ArnavMK/WaveForge/Galery/Boards/Shoyu/3D.png

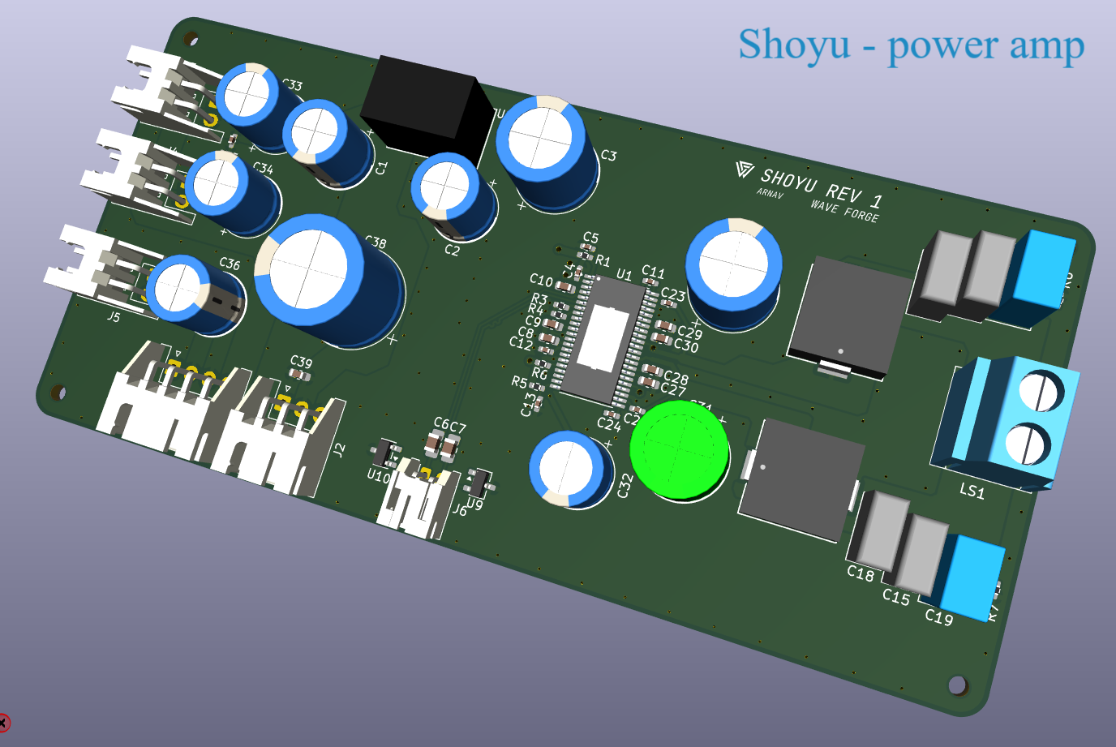
Galery/Boards/Shoyu/3D.png
