ArnavMK/WaveForge/Galery/Boards/Gen/3D.png

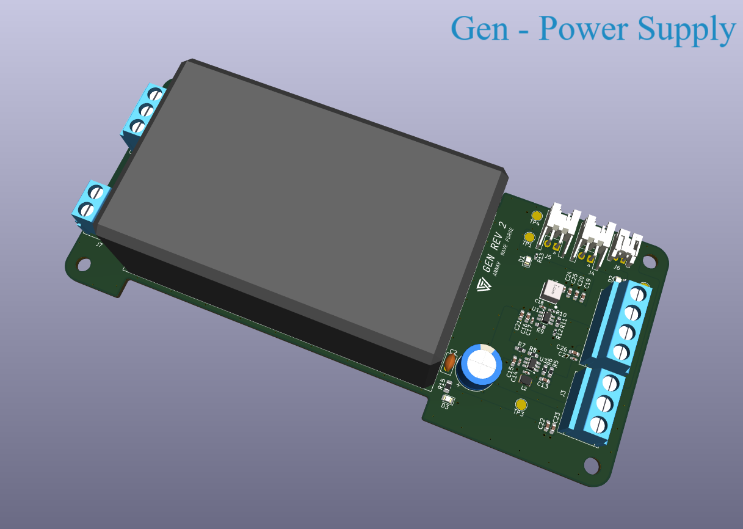
Galery/Boards/Gen/3D.png
