ArnavMK/WaveForge/Galery/Boards/Gen/back_layer.png

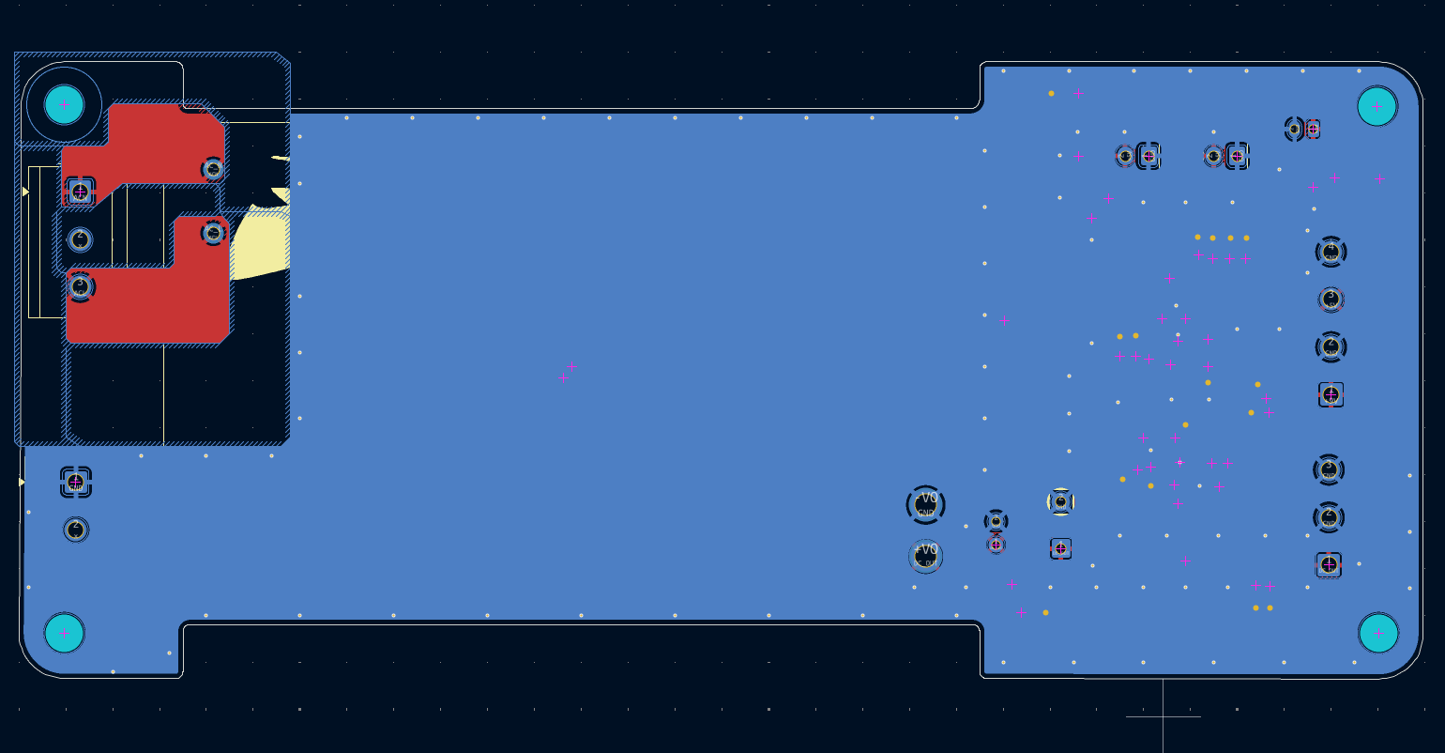
Galery/Boards/Gen/back_layer.png
