ArnavMK/WaveForge/Galery/Boards/Gen/front_layer.png

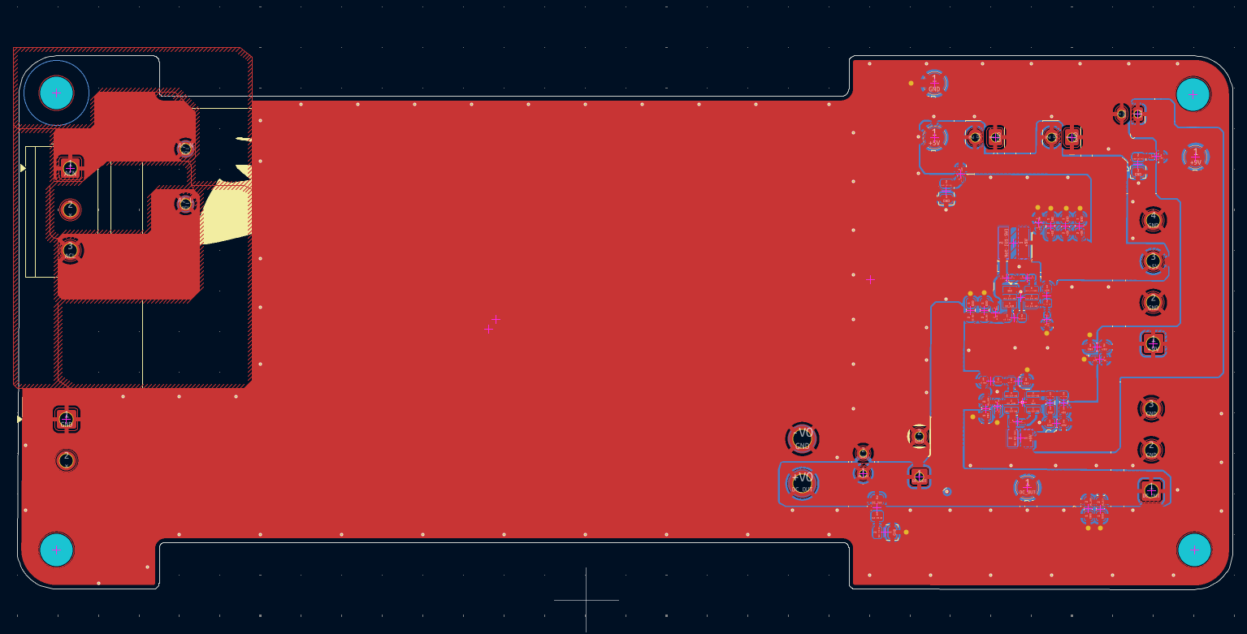
Galery/Boards/Gen/front_layer.png
