ArnavMK/WaveForge/Galery/Boards/Gen/full_board.png

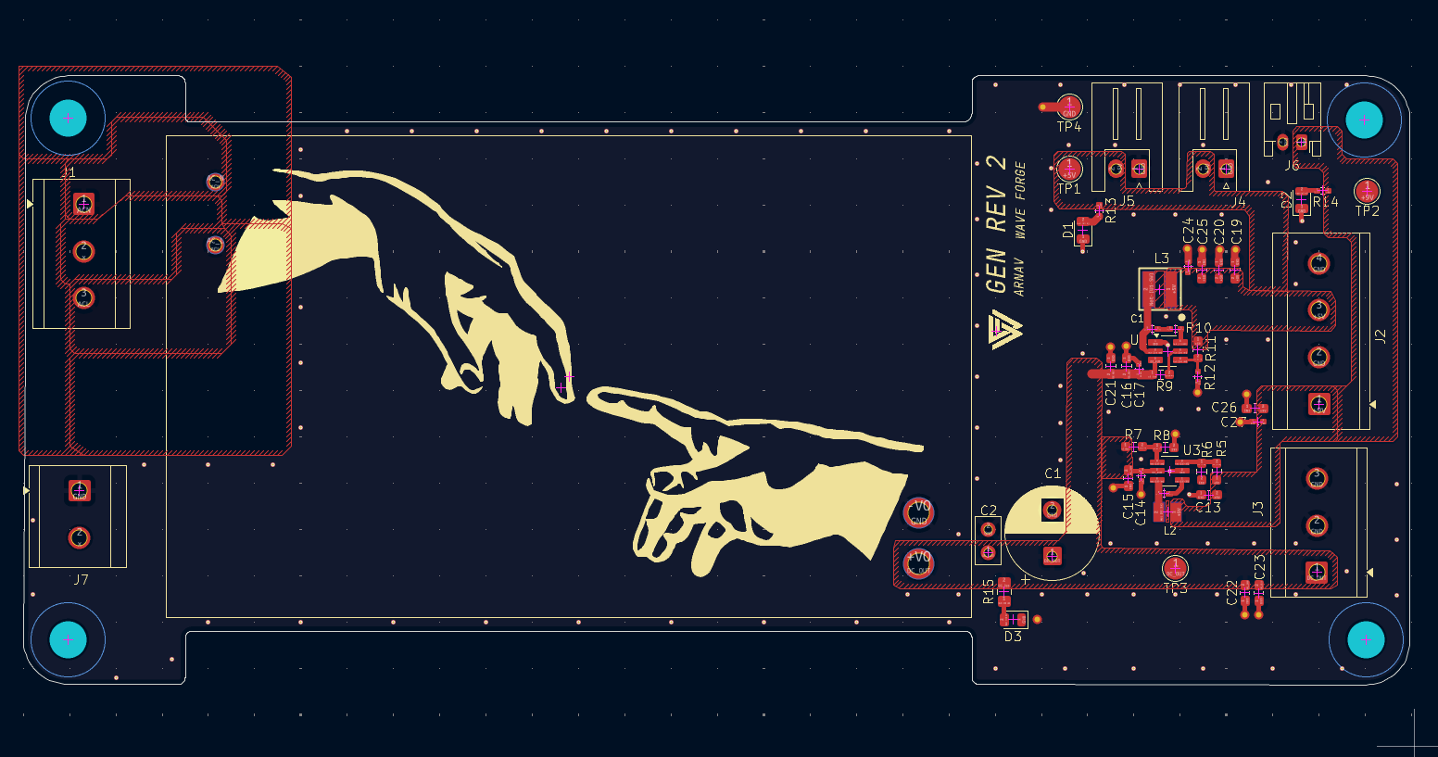
Galery/Boards/Gen/full_board.png
