ArnavMK/WaveForge/Galery/Boards/Gen/schems.png

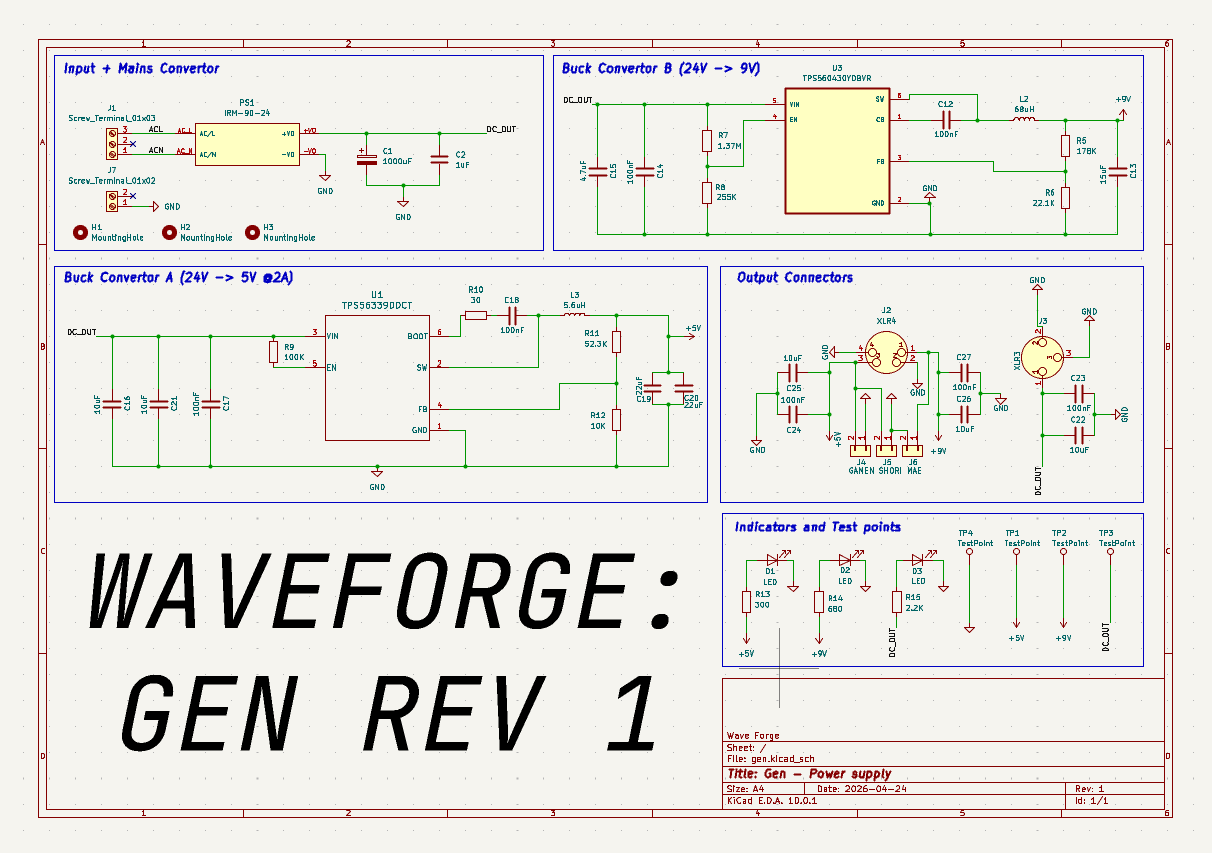
Galery/Boards/Gen/schems.png
