ArnavMK/WaveForge/Galery/Boards/Mae/3D.png

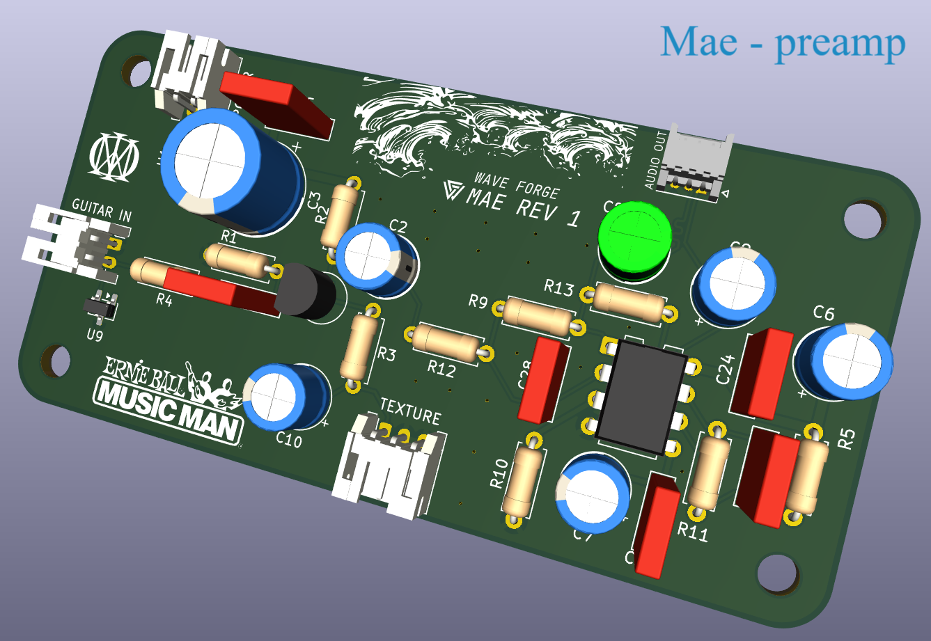
Galery/Boards/Mae/3D.png
