ArnavMK/WaveForge/Galery/Boards/Mae/back_layer.png

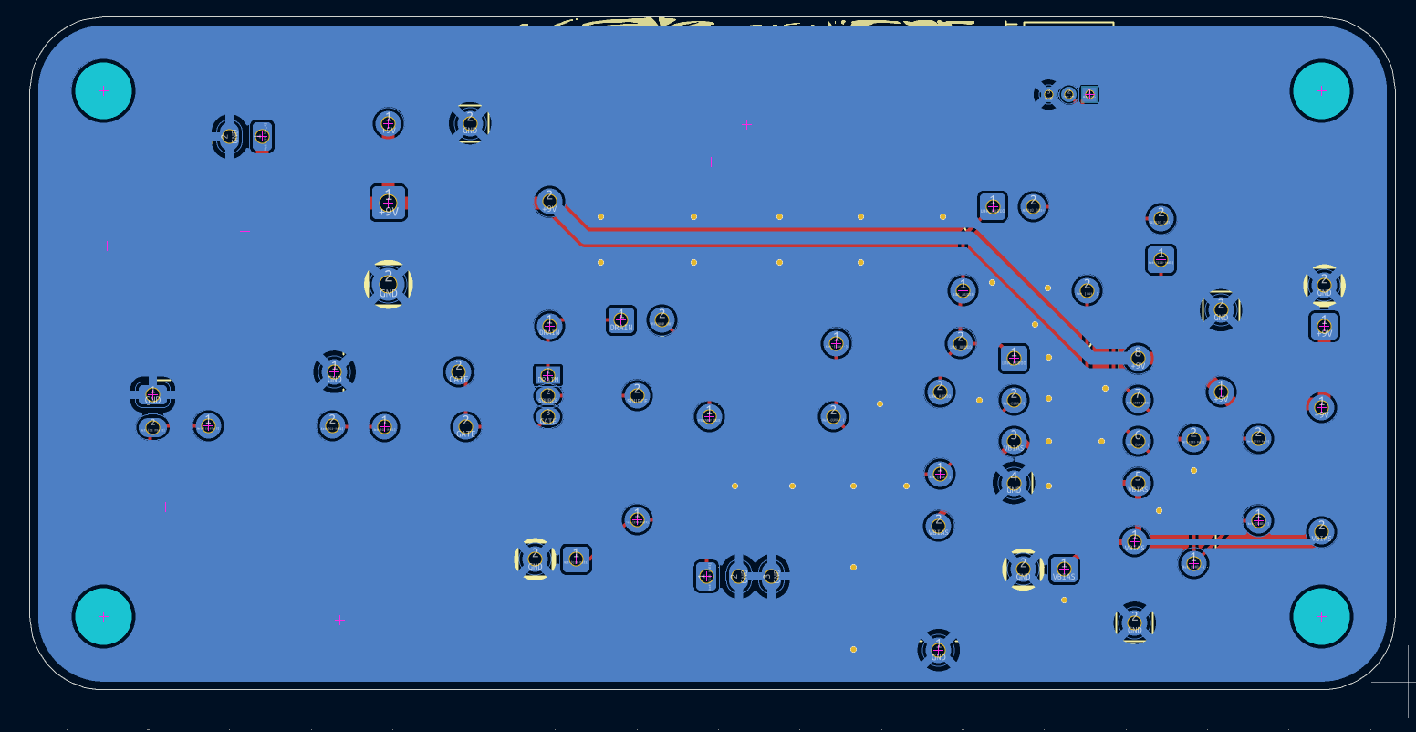
Galery/Boards/Mae/back_layer.png
