ArnavMK/WaveForge/Galery/Boards/Mae/front_layer.png

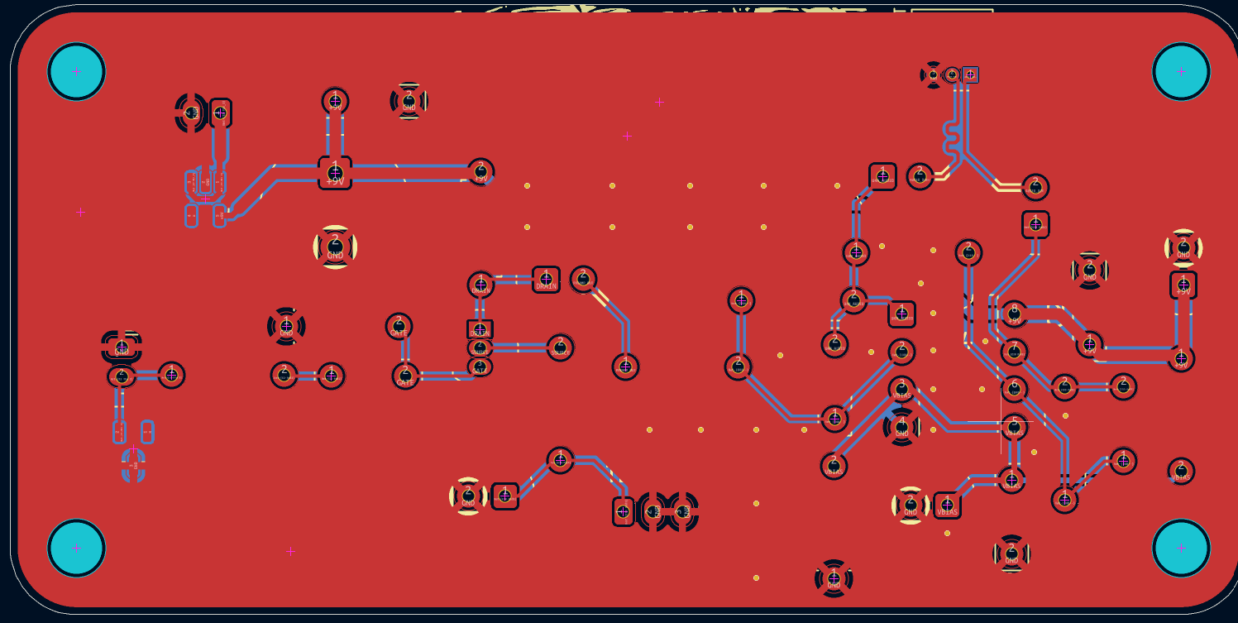
Galery/Boards/Mae/front_layer.png
