ArnavMK/WaveForge/Galery/Boards/Mae/full_board.png

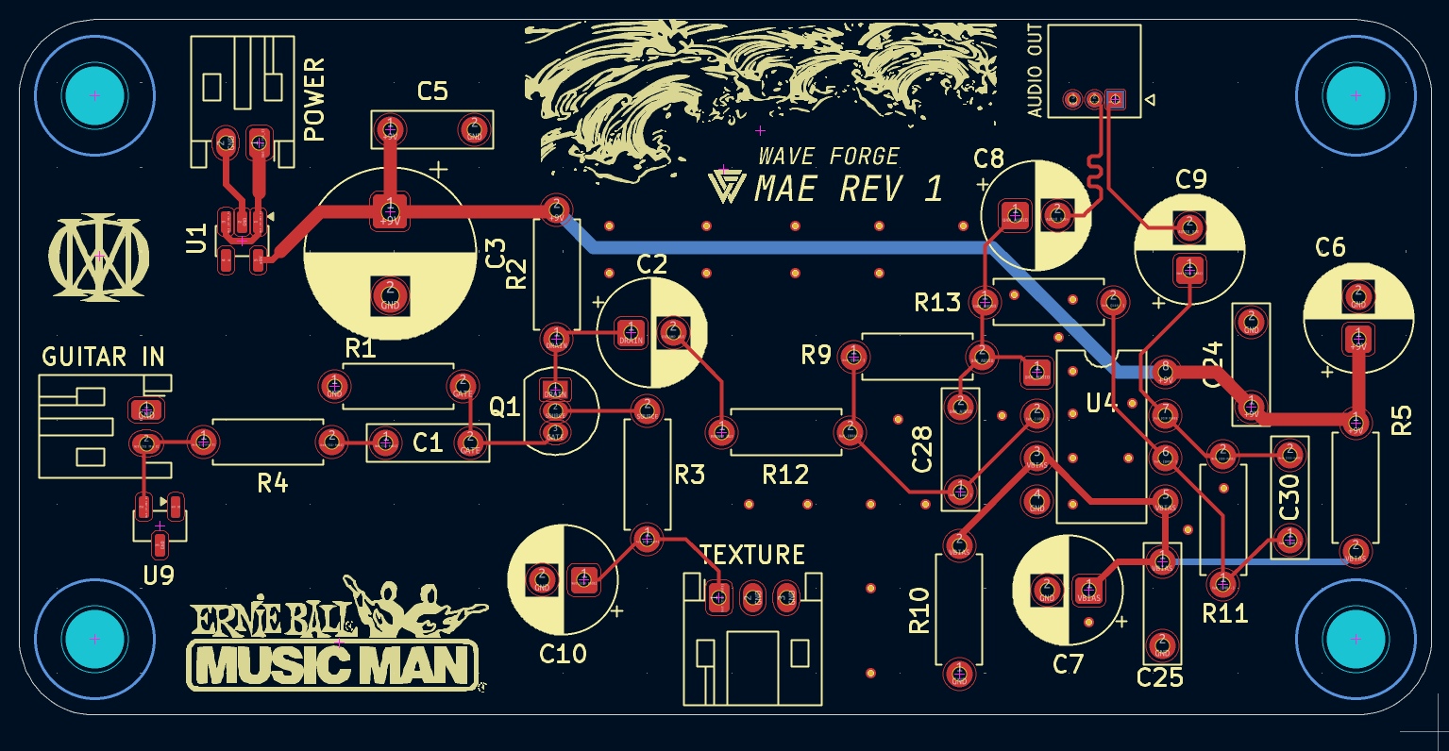
Galery/Boards/Mae/full_board.png
