ArnavMK/WaveForge/Galery/Boards/Shori/3D.png

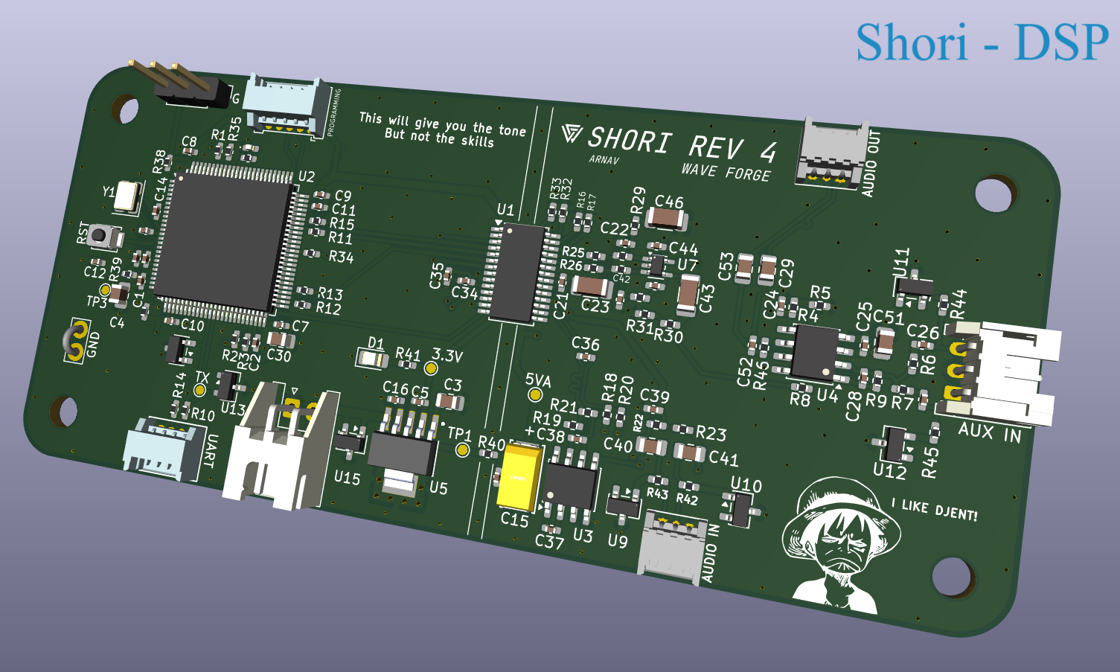
Galery/Boards/Shori/3D.png
