ArnavMK/WaveForge/Galery/Boards/Shori/BackLayer.png

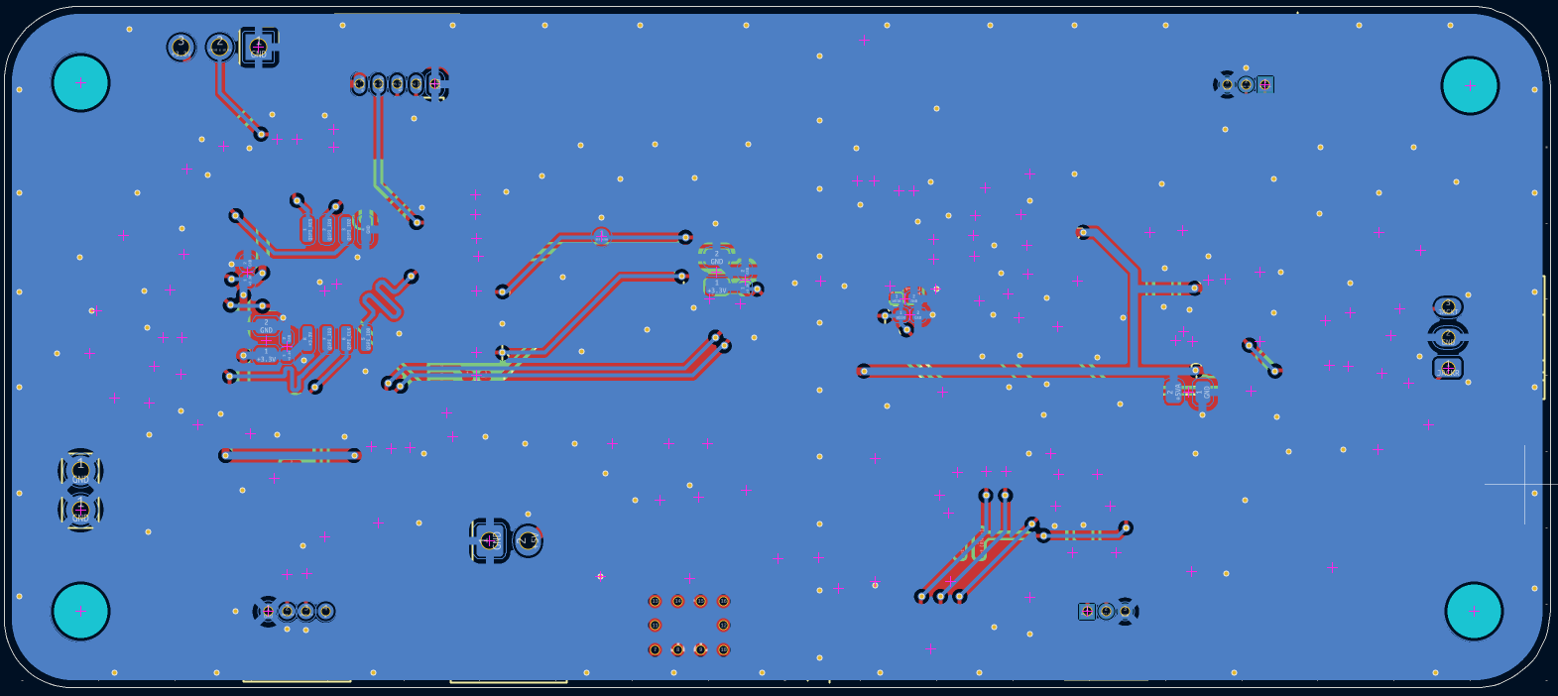
Galery/Boards/Shori/BackLayer.png
