ArnavMK/WaveForge/Galery/Boards/Shori/FrontLayer.png

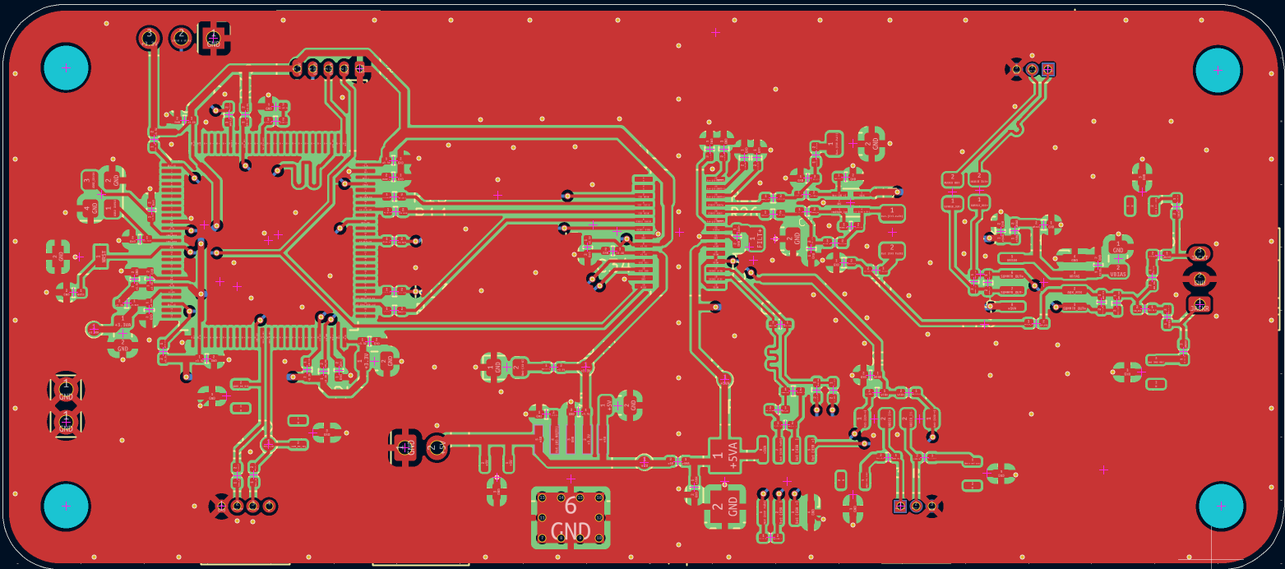
Galery/Boards/Shori/FrontLayer.png
