ArnavMK/WaveForge/Galery/Boards/Shori/Layer2.png

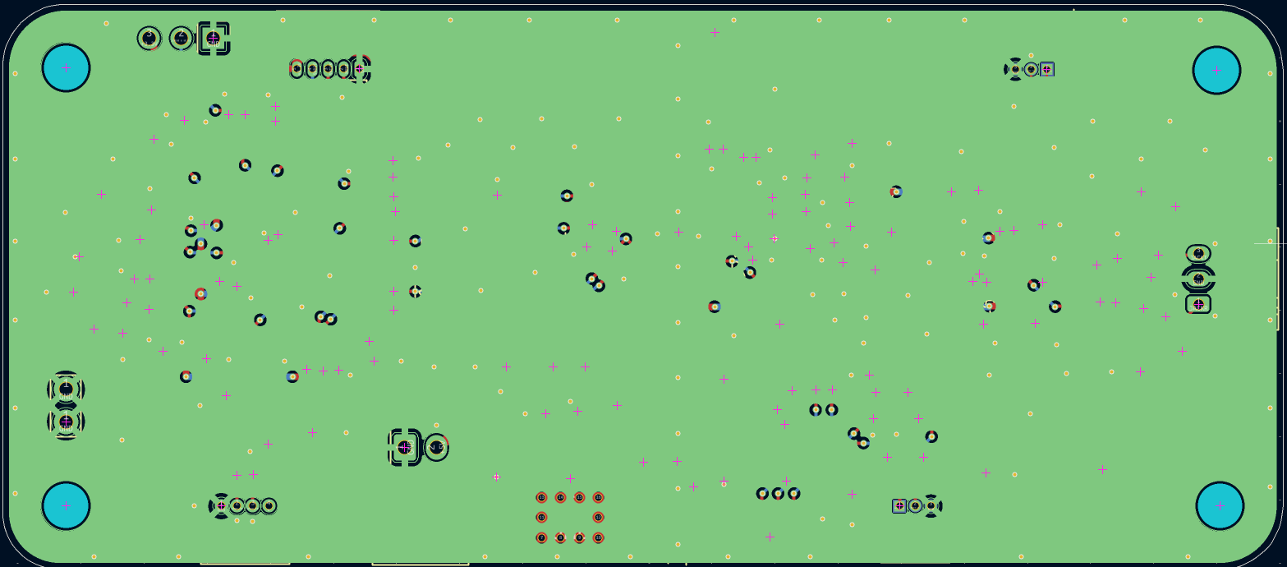
Galery/Boards/Shori/Layer2.png
