ArnavMK/WaveForge/Galery/Boards/Shori/Layer 3.png

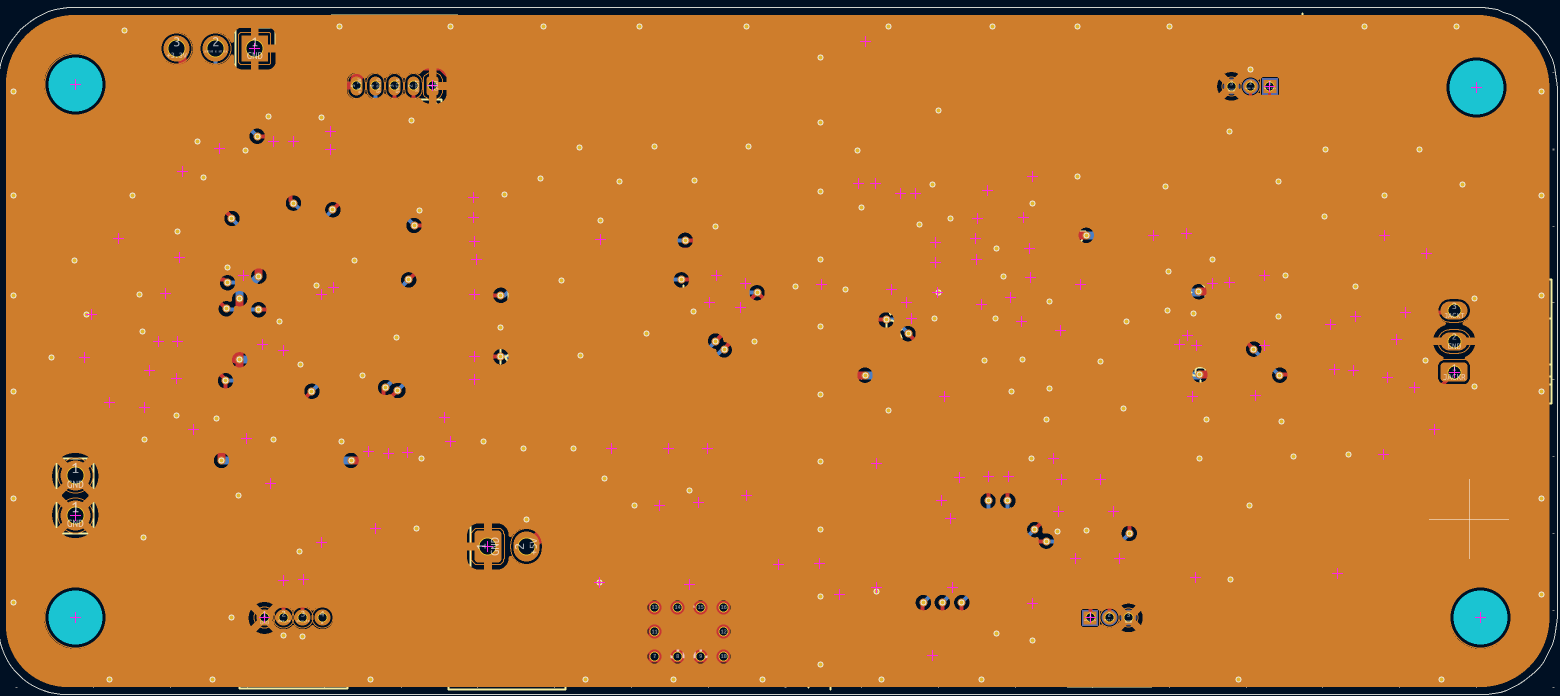
Galery/Boards/Shori/Layer 3.png
