ArnavMK/WaveForge/Galery/Boards/Shori/Screenshot 2026-06-24 115803.png

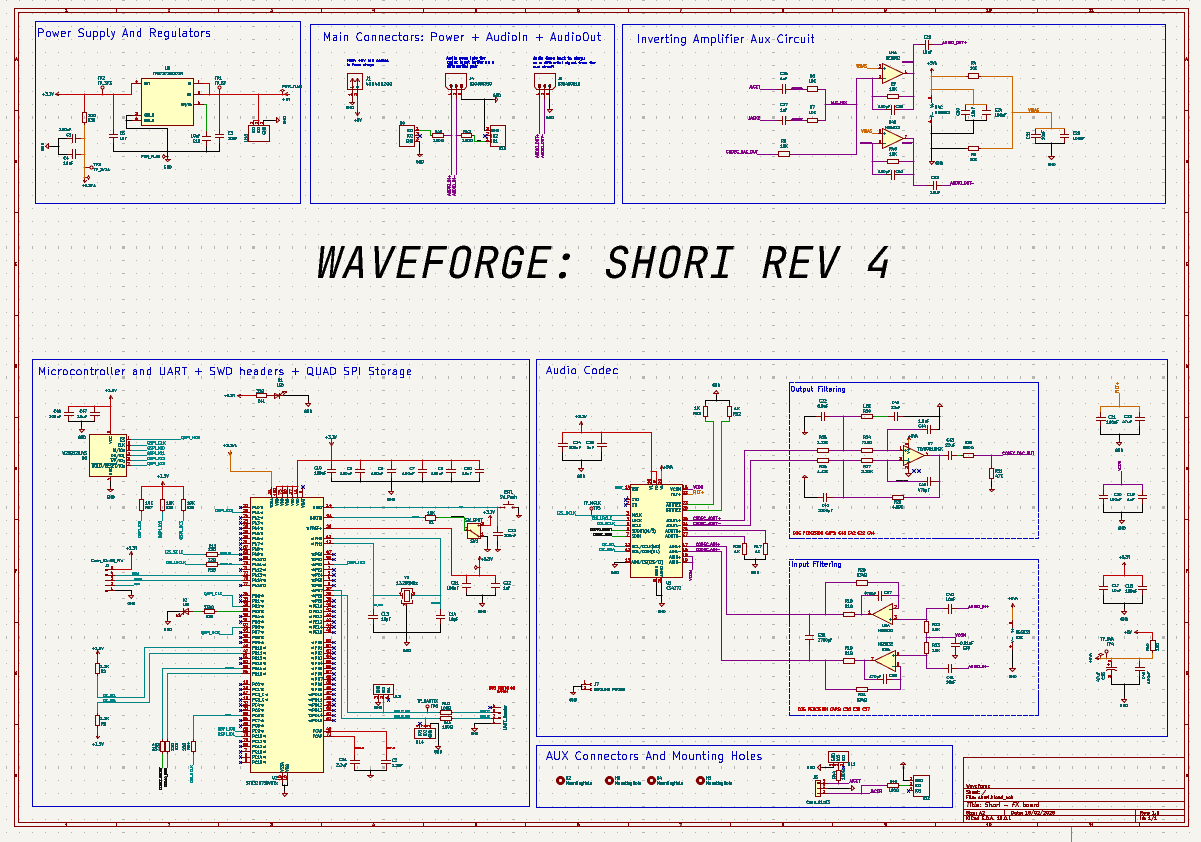
Galery/Boards/Shori/Screenshot 2026-06-24 115803.png
