ArnavMK/WaveForge/Galery/Boards/Shoyu/back_layer.png

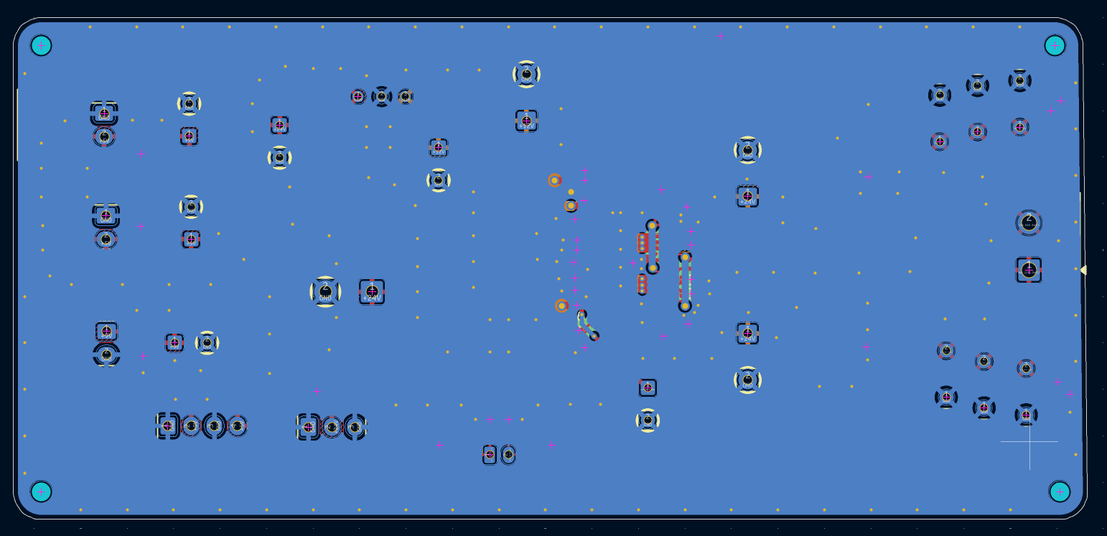
Galery/Boards/Shoyu/back_layer.png
