ArnavMK/WaveForge/Galery/Boards/Shoyu/front_layer.png

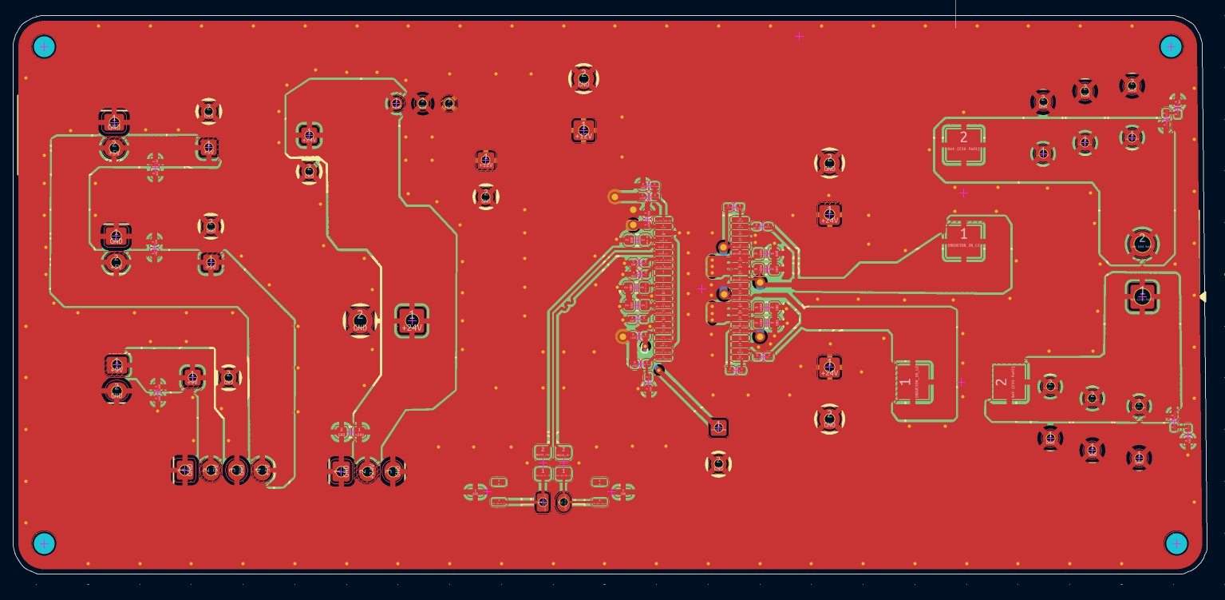
Galery/Boards/Shoyu/front_layer.png
