ArnavMK/WaveForge/Galery/Boards/Shoyu/full_board.png

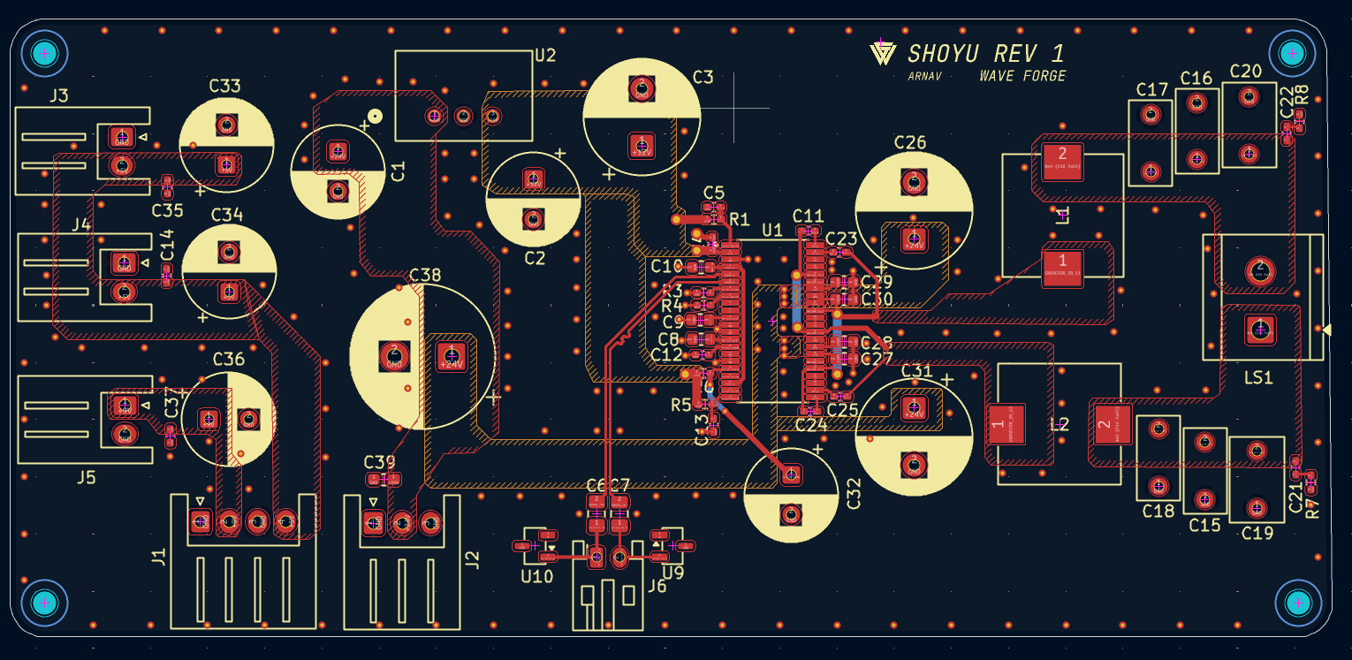
Galery/Boards/Shoyu/full_board.png
