ArnavMK/WaveForge/Galery/Boards/Shoyu/layer-3 - Copy.png

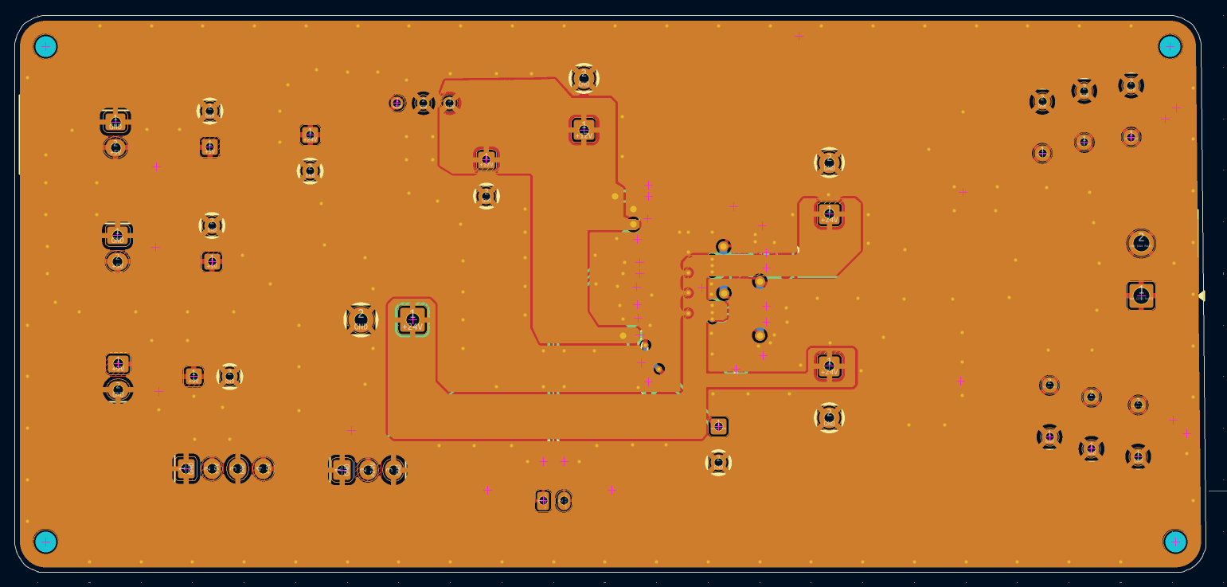
Galery/Boards/Shoyu/layer-3 - Copy.png
