ArnavMK/WaveForge/Galery/Boards/Shoyu/schems - Copy.png

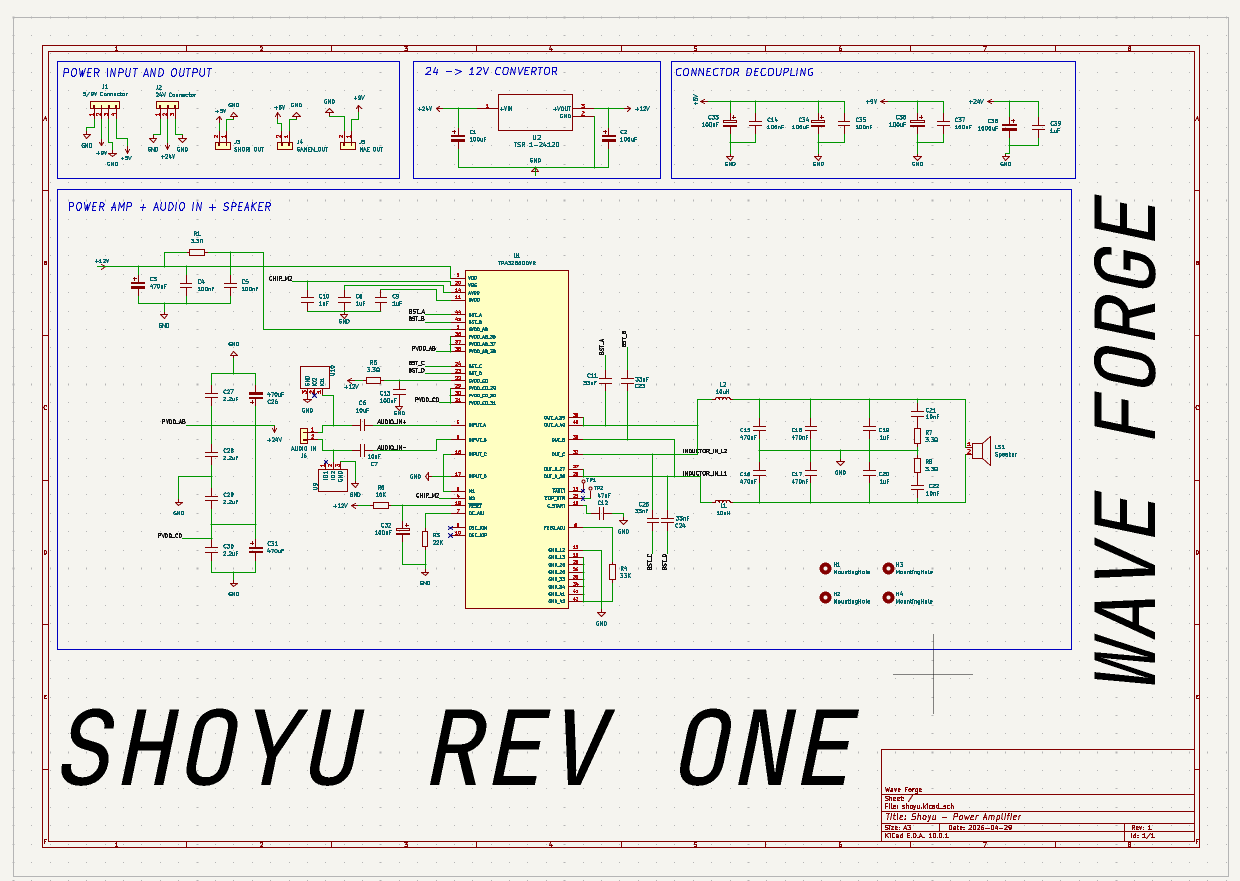
Galery/Boards/Shoyu/schems - Copy.png
