ArnavMK/WaveForge/Galery/Shori Rev 2 Reddit/Layout_No_Zone.png

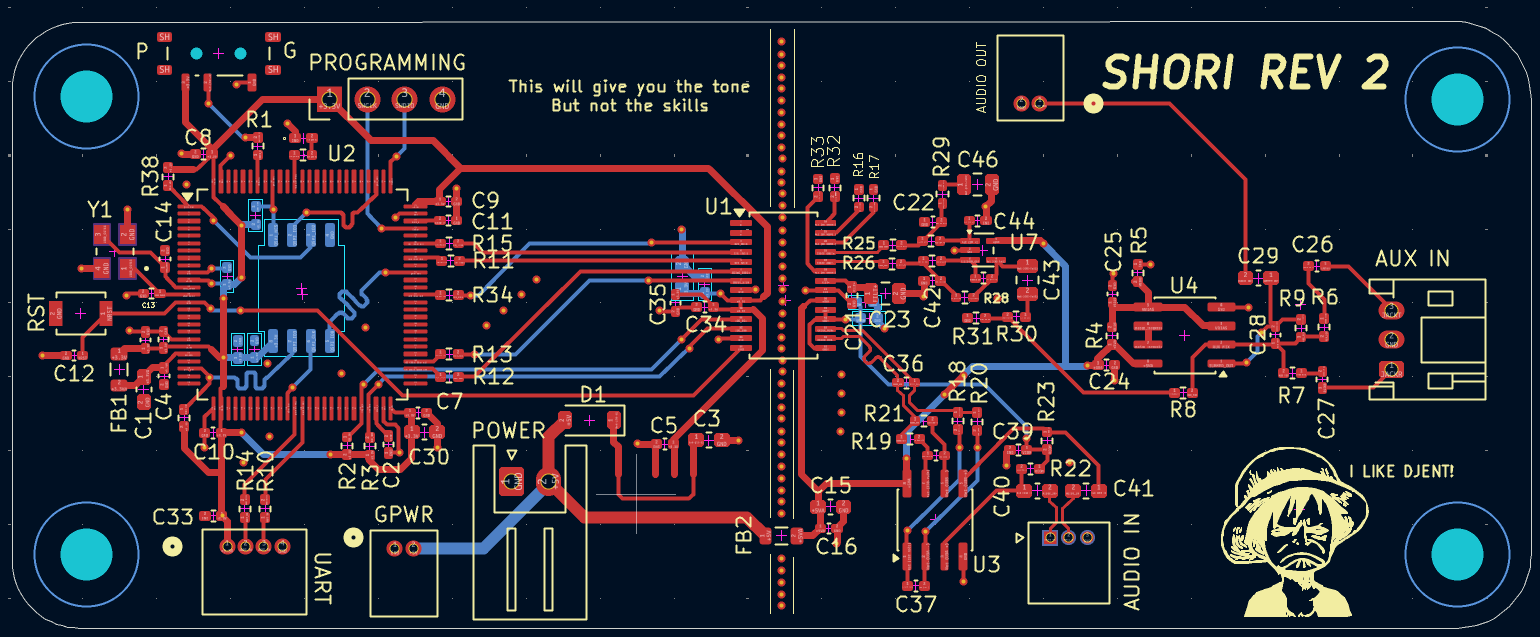
Galery/Shori Rev 2 Reddit/Layout_No_Zone.png
