ArnavMK/WaveForge/Hardware/Gen/gen.kicad_pcb

## KiCad design Hardware/Gen/gen.kicad_pcb (2026-09-25)

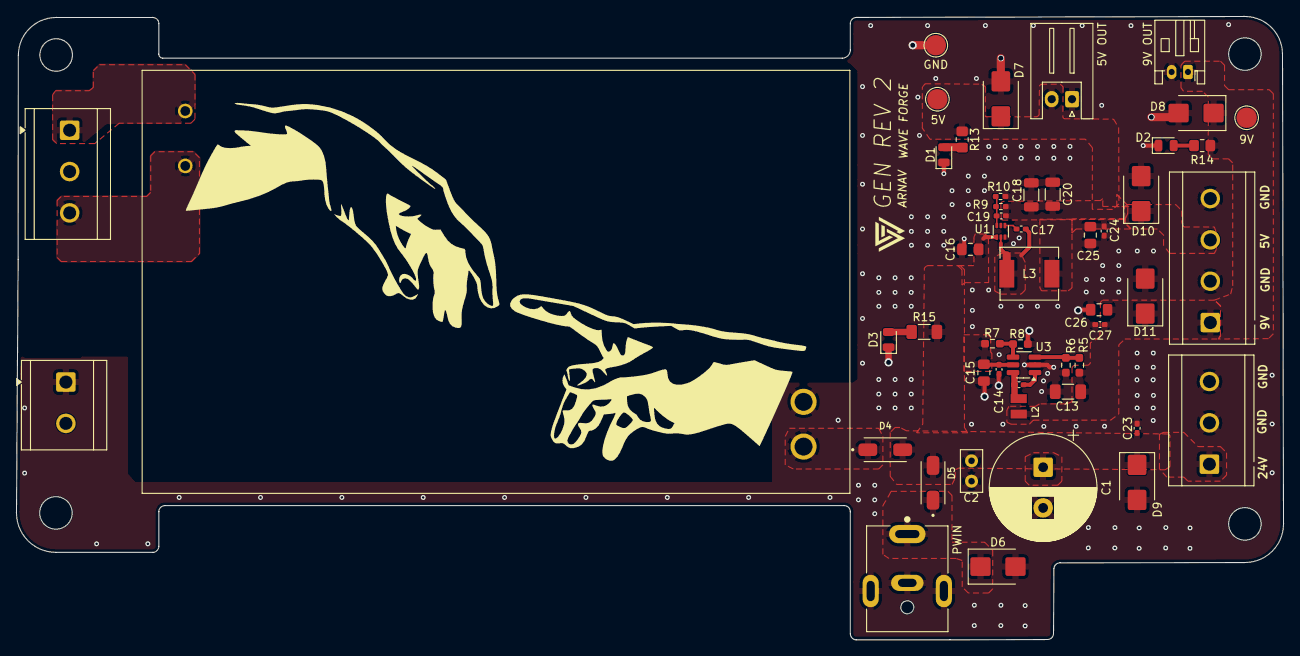
[picture p23: board gen.kicad_pcb from above]

Board: 2 copper layers, 155.8 x 76.6 mm, 55 parts (0 on the bottom side), 18 nets.

Parts:
5V, 9V: TestPoint; TestPoint_Pad_D2.5mm
5V OUT: SHORI; JST_XH_S2B-XH-A_1x02_P2.50mm_Horizontal
9V OUT: MAE; JST_PH_S2B-PH-K_1x02_P2.00mm_Horizontal
C1: 1000uF; CP_Radial_D13.0mm_P5.00mm
C2: 1uF; C_Disc_D5.0mm_W2.5mm_P2.50mm
C12, C14, C17, C23, C24, C27: 100nF; C_0402_1005Metric_Pad0.74x0.62mm_HandSolder
C13: 15uF; C_1206_3216Metric_Pad1.33x1.80mm_HandSolder
C15: 4.7uF; C_0805_2012Metric_Pad1.18x1.45mm_HandSolder
C16: 3.3uF; C_0805_2012Metric_Pad1.18x1.45mm_HandSolder
C18, C20: 47uF; C_1206_3216Metric
C19: 82pF; C_0402_1005Metric_Pad0.74x0.62mm_HandSolder
C25, C26: 10uF; C_0805_2012Metric_Pad1.18x1.45mm_HandSolder
D1, D2, D3: LED; LED_0805_2012Metric
D4, D5: B340; DIOM5226X240N
D6, D9: SMBJ28A; D_SMB
D7, D8, D10, D11: SMBJ6.0A; D_SMB
GND: TestPoint; TestPoint_Pad_D2.5mm
H1, H2, H3, H3#2: MountingHole; MountingHole_4mm
J1: Screw_Terminal_01x03; TerminalBlock_CUI_TB007-508-03_1x03_P5.08mm_Horizontal
J2: XLR4; TerminalBlock_CUI_TB007-508-04_1x04_P5.08mm_Horizontal
J3: XLR3; TerminalBlock_CUI_TB007-508-03_1x03_P5.08mm_Horizontal
L2: 68uH; WE-LQS_2512
L3: 10uH; IND_SRP6540-100M
MAINS TO GROUND: Screw_Terminal_01x02; TerminalBlock_CUI_TB007-508-02_1x02_P5.08mm_Horizontal
PS1: IRM-90-24; CONV_IRM-90-24
PWIN: PJ-063BH; CUI_PJ-063BH
R5: 178K; R_0603_1608Metric_Pad0.98x0.95mm_HandSolder
R6: 22.1K; R_0603_1608Metric_Pad0.98x0.95mm_HandSolder
R7: 1.37M; R_0603_1608Metric_Pad0.98x0.95mm_HandSolder
R8: 255K; R_0603_1608Metric_Pad0.98x0.95mm_HandSolder
R9: 107K; R_0402_1005Metric_Pad0.72x0.64mm_HandSolder
R10: 13.7K; R_0402_1005Metric_Pad0.72x0.64mm_HandSolder
R13: 300; R_0805_2012Metric_Pad1.20x1.40mm_HandSolder
R14: 680; R_0805_2012Metric_Pad1.20x1.40mm_HandSolder
R15: 2.2K; R_1206_3216Metric_Pad1.30x1.75mm_HandSolder
U1: TPS543021DRLR; SOT-563
U3: TPS560430YDBVR; SOT-23-6_Handsoldering

Connections:
+5V: 5V.1 (1_1), 5V OUT.2, C18.2, C19.1, C20.2, C24.2, C25.2, D7.1 (K), D10.1 (K), J2.3, L3.1, R9.1, R13.2
+9V: 9V.1 (1_1), 9V OUT.1, C13.2, C26.2, C27.2, D8.1 (K), D11.1 (K), J2.1, L2.1, R5.1, R14.2
/ACL: J1.3, PS1.AC_L (AC/L)
/ACN: J1.1, PS1.AC_N (AC/N)
/DC_OUT: C1.1, C2.1, C14.2, C15.2, C16.2, C23.2, D4.1 (K), D5.1 (K), D9.1 (K), J3.1, R7.1, R15.2, U1.1 (VIN), U3.5 (VIN)
GND: 5V OUT.1, 9V OUT.2, C1.2, C2.2, C13.1, C14.1, C15.1, C16.1, C18.1, C20.1, C23.1, C24.1, C25.1, C26.1, C27.1, D1.1 (K), D2.1 (K), D3.1 (K), D6.2 (A), D7.2 (A), D8.2 (A), D9.2 (A), D10.2 (A), D11.2 (A), GND.1 (1_1), J2.2, J2.4, J3.2, J3.3, MAINS TO GROUND.1 (Pin_1_1), PS1.-VO, PWIN.2, PWIN.S1 (SHIELD), PWIN.S2 (SHIELD__1), R6.2, R8.2, R10.2, U1.3 (GND), U3.2 (GND)
unnamed: D1.2 (A), R13.1
unnamed: D2.2 (A), R14.1
unnamed: D3.2 (A), R15.1
unnamed: D4.2 (A), PS1.+VO
unnamed: D5.2 (A), D6.1 (K), PWIN.1
unnamed: C17.2, U1.4 (BOOT)
unnamed: C19.2, R9.2, R10.1, U1.6 (FB)
unnamed: C17.1, L3.2, U1.2 (SW)
unnamed: C12.2, U3.1 (CB)
unnamed: R7.2, R8.1, U3.4 (EN)
unnamed: R5.2, R6.1, U3.3 (FB)
unnamed: C12.1, L2.2, U3.6 (SW)
