ArnavMK/WaveForge/Hardware/shori/shori.kicad_pcb

## KiCad design Hardware/shori/shori.kicad_pcb (2026-09-25)

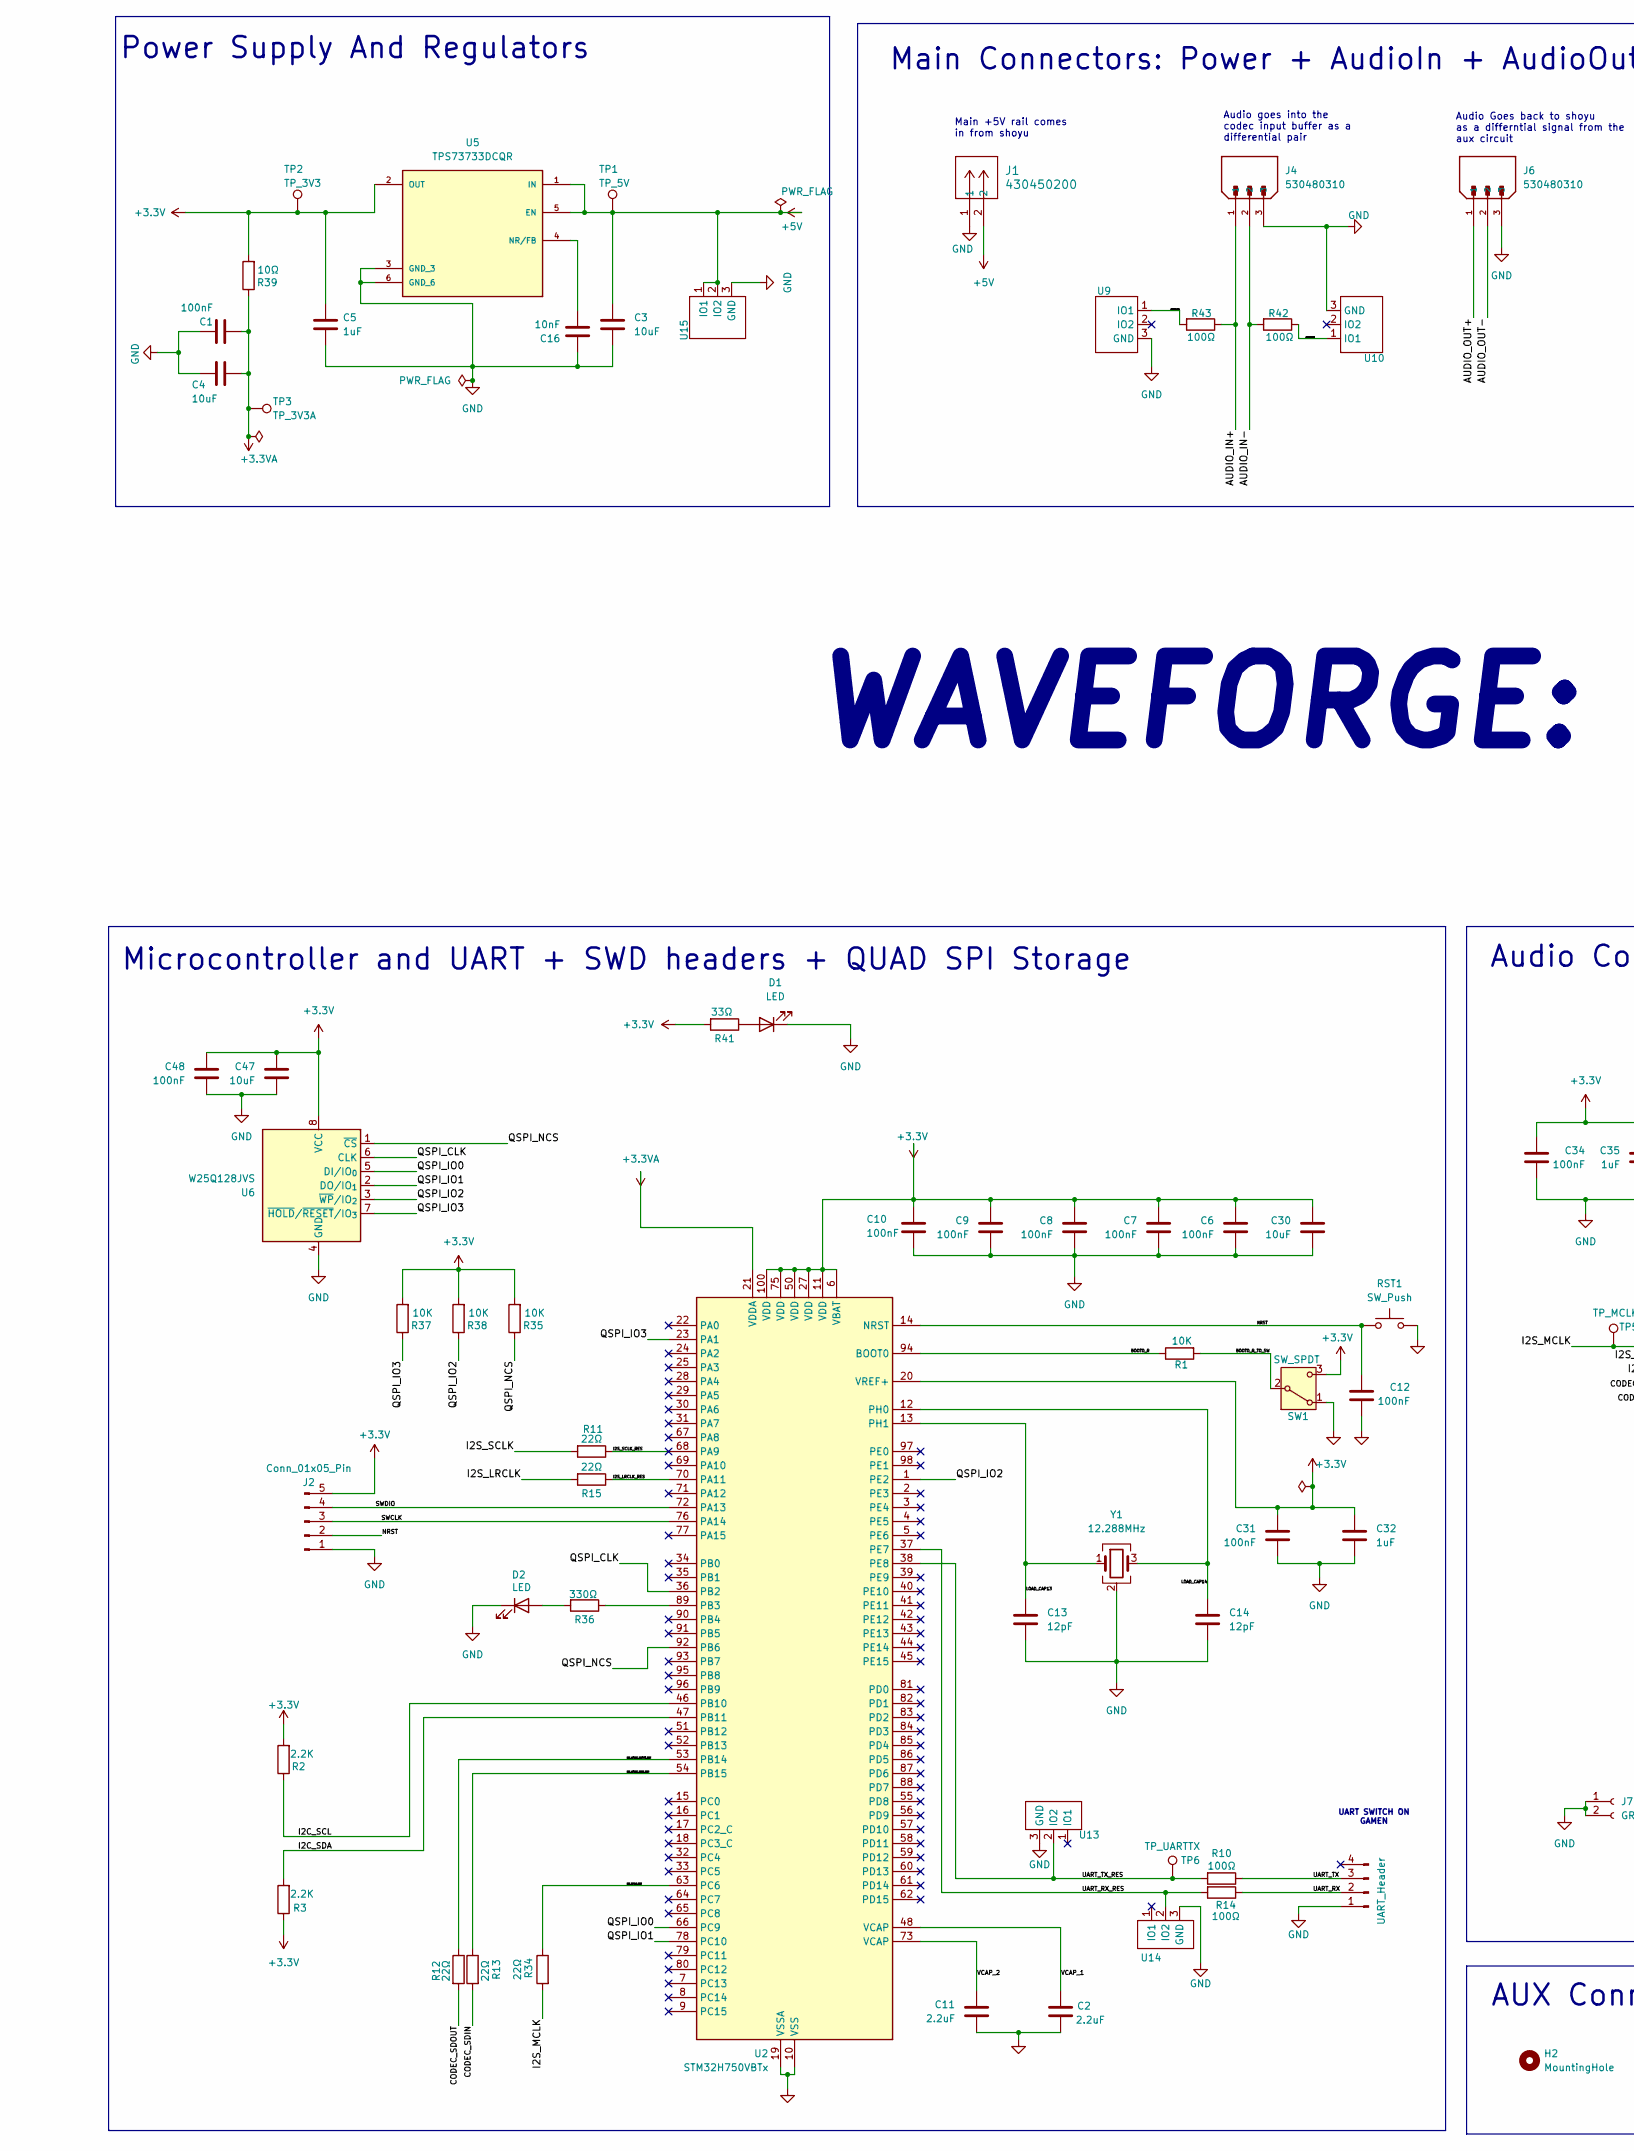
[picture p24: schematic shori.kicad_sch, Shori - FX board, part in row 1, column 1]

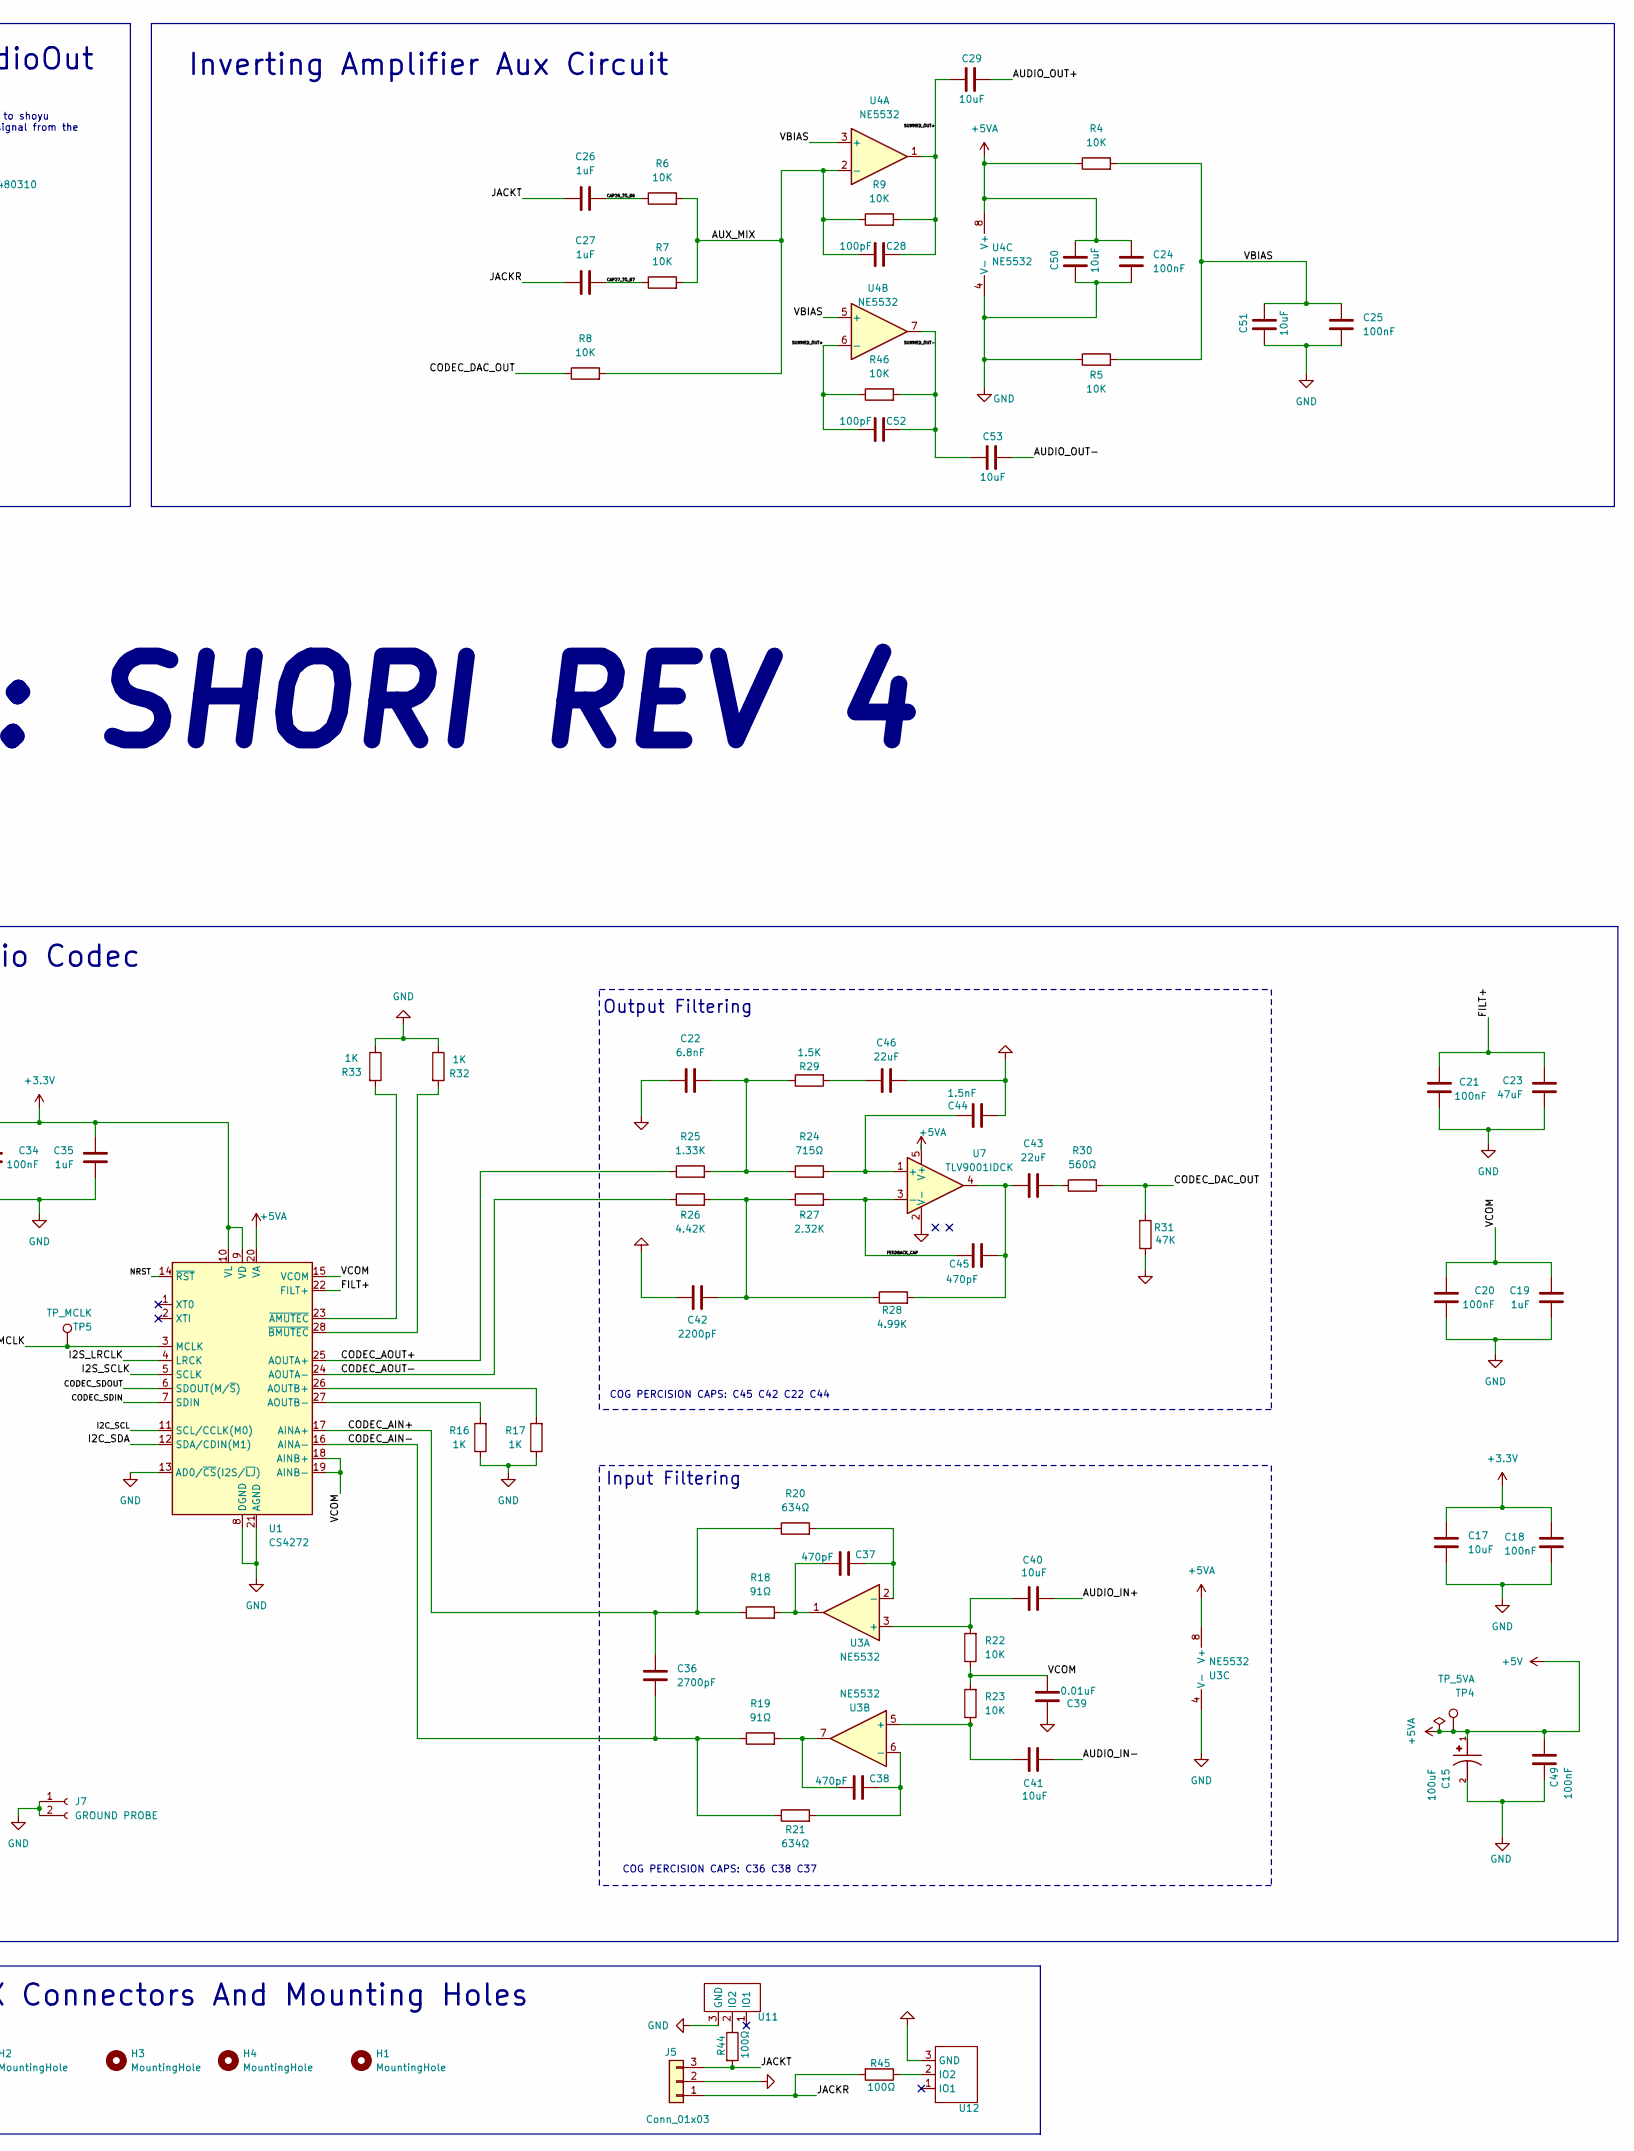
[picture p25: schematic shori.kicad_sch, Shori - FX board, part in row 1, column 2]

Parts:
C1, C6, C7, C8, C9, C10, C12, C18, C20, C21, C24, C25, C31, C34, C48, C49: 100nF; C_0402_1005Metric_Pad0.74x0.62mm_HandSolder
C2, C11: 2.2uF; C_0402_1005Metric_Pad0.74x0.62mm_HandSolder
C3, C4, C17, C29, C30, C40, C41, C47, C50, C51, C53: 10uF; C_0805_2012Metric
C5, C19, C26, C27, C32, C35: 1uF; C_0402_1005Metric_Pad0.74x0.62mm_HandSolder
C13, C14: 12pF; C_0402_1005Metric_Pad0.74x0.62mm_HandSolder
C15: 100uF; CAPMP6.3X3.2_2.8N_KEM; PARTREV 3
C16: 10nF; C_0402_1005Metric_Pad0.74x0.62mm_HandSolder
C22: 6.8nF; C_0402_1005Metric_Pad0.74x0.62mm_HandSolder
C23: 47uF; C_1206_3216Metric
C28, C52: 100pF; C_0402_1005Metric_Pad0.74x0.62mm_HandSolder
C36: 2700pF; C_0402_1005Metric_Pad0.74x0.62mm_HandSolder
C37, C38, C45: 470pF; C_0402_1005Metric_Pad0.74x0.62mm_HandSolder
C39: 0.01uF; C_0402_1005Metric_Pad0.74x0.62mm_HandSolder
C42: 2200pF; C_0402_1005Metric_Pad0.74x0.62mm_HandSolder
C43, C46: 22uF; C_1206_3216Metric
C44: 1.5nF; C_0402_1005Metric_Pad0.74x0.62mm_HandSolder
D1: LED; LED_0805_2012Metric_Pad1.15x1.40mm_HandSolder
D2: LED; LED_0402_1005Metric_Pad0.77x0.64mm_HandSolder
H1, H2, H3, H4: MountingHole; MountingHole_3.5mm
J1: 430450200; JST_XH_S2B-XH-A_1x02_P2.50mm_Horizontal
J2: Conn_01x05_Pin; PinHeader_1x05_P2.54mm_Vertical
J3: UART_Header; MOLEX_530480310
J4, J6: 530480310; MOLEX_530480310; PARTREV A
J5: Conn_01x03; JST_PH_S3B-PH-K_1x03_P2.00mm_Horizontal
J7: GROUND PROBE; PinSocket_1x02_P2.00mm_Vertical
R1, R4, R5, R6, R7, R8, R9, R22, R23, R35, R37, R38, R46: 10K; R_0402_1005Metric_Pad0.72x0.64mm_HandSolder
R2, R3: 2.2K; R_0402_1005Metric_Pad0.72x0.64mm_HandSolder
R10, R14, R42, R43, R44, R45: 100Ω; R_0402_1005Metric_Pad0.72x0.64mm_HandSolder
R11, R12, R13, R15, R34: 22Ω; R_0402_1005Metric_Pad0.72x0.64mm_HandSolder
R16, R17, R32, R33: 1K; R_0402_1005Metric_Pad0.72x0.64mm_HandSolder
R18, R19: 91Ω; R_0402_1005Metric_Pad0.72x0.64mm_HandSolder
R20, R21: 634Ω; R_0402_1005Metric_Pad0.72x0.64mm_HandSolder
R24: 715Ω; R_0402_1005Metric_Pad0.72x0.64mm_HandSolder
R25: 1.33K; R_0402_1005Metric_Pad0.72x0.64mm_HandSolder
R26: 4.42K; R_0402_1005Metric_Pad0.72x0.64mm_HandSolder
R27: 2.32K; R_0402_1005Metric_Pad0.72x0.64mm_HandSolder
R28: 4.99K; R_0402_1005Metric_Pad0.72x0.64mm_HandSolder
R29: 1.5K; R_0402_1005Metric_Pad0.72x0.64mm_HandSolder
R30: 560Ω; R_0402_1005Metric_Pad0.72x0.64mm_HandSolder
R31: 47K; R_0402_1005Metric_Pad0.72x0.64mm_HandSolder
R36: 330Ω; R_0402_1005Metric_Pad0.72x0.64mm_HandSolder
R39: 10Ω; R_0402_1005Metric_Pad0.72x0.64mm_HandSolder
R41: 33Ω; R_0402_1005Metric_Pad0.72x0.64mm_HandSolder
RST1: SW_Push; SW_SPST_B3U-1000P
SW1: SW_SPDT; PinHeader_1x03_P2.54mm_Vertical
TP1: TP_5V; TestPoint_Pad_D1.0mm
TP2: TP_3V3; TestPoint_Pad_D1.0mm
TP3: TP_3V3A; TestPoint_Pad_D1.0mm
TP4: TP_5VA; TestPoint_Pad_D1.0mm
TP5: TP_MCLK; TestPoint_Pad_D1.0mm
TP6: TP_UARTTX; TestPoint_Pad_D1.0mm
U1: CS4272; TSSOP-28_4.4x9.7mm_P0.65mm
U2: STM32H750VBTx; LQFP-100_14x14mm_P0.5mm
U3, U4: NE5532; SOIC-8_3.9x4.9mm_P1.27mm
U5: TPS73733DCQR; IC_TPS73733DCQR; PARTREV R
U6: W25Q128JVS; SOIC-8_5.3x5.3mm_P1.27mm
U7: TLV9001IDCK; SOT-353_SC-70-5
U9, U10, U11, U12, U13, U14, U15: SOT-23-3
Y1: 12.288MHz; Crystal_SMD_3225-4Pin_3.2x2.5mm

Connections:
+3.3V: C5.1, C6.1, C7.1, C8.1, C9.1, C10.1, C17.1, C18.1, C30.1, C31.1, C32.1, C34.1, C35.1, C47.1, C48.1, J2.5, R2.2, R3.1, R35.2, R37.2, R38.2, R39.2, R41.2, SW1.3 (C), TP2.1 (1_1), U1.9 (VD), U1.10 (VL), U2.6 (VBAT), U2.11 (VDD), U2.20 (VREF+), U2.27 (VDD), U2.50 (VDD), U2.75 (VDD), U2.100 (VDD), U5.2 (OUT), U6.8 (VCC); also elsewhere on the board
+3.3VA: C1.1, C4.1, R39.1, TP3.1 (1_1), U2.21 (VDDA)
+5V: C3.1, C15.1, C24.1, C49.1, C50.2, J1.2, R4.1, TP1.1 (1_1), TP4.1 (1_1), U1.20 (VA), U3.8 (V+), U4.8 (V+), U5.1 (IN), U5.5 (EN), U7.5 (V+), U15.1 (IO1), U15.2 (IO2)
/AUDIO_IN+: C40.2, J4.1, R43.1
/AUDIO_IN-: C41.2, J4.2, R42.2
/AUDIO_OUT+: C29.2, J6.1
/AUDIO_OUT-: C53.2, J6.2
/AUX_MIX: C28.1, R6.2, R7.2, R8.2, R9.1, U4.2 (-)
/BOOT0_R: R1.1, U2.94 (BOOT0)
/BOOT0_R_TO_SW: R1.2, SW1.2 (B); also elsewhere on the board
/CAP26_TO_R6: C26.2, R6.1
/CAP27_TO_R7: C27.2, R7.1
/CODEC_AIN+: C36.1, R18.1, R20.1, U1.17 (AINA+)
/CODEC_AIN-: C36.2, R19.1, R21.1, U1.16 (AINA-)
/CODEC_AOUT+: R25.1, U1.25 (AOUTA+)
/CODEC_AOUT-: R26.1, U1.24 (AOUTA-)
/CODEC_DAC_OUT: R8.1, R30.2, R31.2
/CODEC_SDIN: R13.2, U1.7 (SDIN)
/CODEC_SDOUT: R12.2, U1.6 (SDOUT(M/~S))
/FEEDBACK_CAP: C45.1, R27.2, U7.3 (-)
/FILT+: C21.1, C23.1, U1.22 (FILT+)
/I2C_SCL: R2.1, U1.11 (SCL/CCLK(M0)), U2.46 (PB10)
/I2C_SDA: R3.2, U1.12 (SDA/CDIN(M1)), U2.47 (PB11)
/I2S_CODEC_SDIN_RES: R13.1, U2.54 (PB15)
/I2S_CODEC_SDOUT_RES: R12.1, U2.53 (PB14)
/I2S_LRCLK: R15.2, U1.4 (LRCK)
/I2S_LRCLK_RES: R15.1, U2.70 (PA11)
/I2S_MCLK: R34.2, TP5.1 (1_1), U1.3 (MCLK)
/I2S_MCLK_RES: R34.1, U2.63 (PC6)
/I2S_SCLK: R11.2, U1.5 (SCLK)
/I2S_SCLK_RES: R11.1, U2.68 (PA9)
/JACKR: C27.1, J5.1, R45.2
/JACKT: C26.1, J5.3, R44.2
/LOAD_CAP13: C13.1, U2.13 (PH1), Y1.1
/LOAD_CAP14: C14.1, U2.12 (PH0), Y1.3
/NRST: C12.1, J2.2, RST1.1, U1.14 (~RST), U2.14 (NRST)
/QSPI_CLK: U2.36 (PB2), U6.6 (CLK)
/QSPI_IO0: U2.66 (PC9), U6.5 (DI/IO_{0})
/QSPI_IO1: U2.78 (PC10), U6.2 (DO/IO_{1})
/QSPI_IO2: R38.1, U2.1 (PE2), U6.3 (~WP/IO_{2})
/QSPI_IO3: R37.1, U2.23 (PA1), U6.7 (~HOLD/~RESET/IO_{3})
/QSPI_NCS: R35.1, U2.92 (PB6), U6.1 (~CS)
/SHUNT_RES_AINM: R42.1, U10.1 (IO1)
/SHUNT_RES_AINP: R43.2, U9.1 (IO1)
/SUMMED_OUT+: C28.2, C29.1, C52.1, R9.2, R46.1, U4.1, U4.6 (-)
/SUMMED_OUT-: C52.2, C53.1, R46.2, U4.7
/SWCLK: J2.3, U2.76 (PA14)
/SWDIO: J2.4, U2.72 (PA13)
/UART_RX: J3.2, R14.1
/UART_RX_RES: R14.2, U2.37 (PE7), U14.2 (IO2)
/UART_TX: J3.3, R10.1
/UART_TX_RES: R10.2, TP6.1 (1_1), U2.38 (PE8), U13.2 (IO2)
/VBIAS: C25.1, C51.2, R4.2, R5.2, U4.3 (+), U4.5 (+)
/VCAP_1: C2.2, U2.48 (VCAP)
/VCAP_2: C11.2, U2.73 (VCAP)
/VCOM: C19.1, C20.1, C39.1, R22.1, R23.2, U1.15 (VCOM), U1.18 (AINB+), U1.19 (AINB-)
GND: C1.2, C2.1, C3.2, C4.2, C5.2, C6.2, C7.2, C8.2, C9.2, C10.2, C11.1, C12.2, C13.2, C14.2, C15.2, C16.1, C17.2, C18.2, C19.2, C20.2, C21.2, C22.1, C23.2, C24.2, C25.2, C30.2, C31.2, C32.2, C34.2, C35.2, C39.2, C42.1, C44.2, C46.2, C47.2, C48.2, C49.2, C50.1, C51.1, D1.1 (K), D2.1 (K), J1.1, J2.1, J3.1, J4.3, J5.2, J6.3, J7.1, J7.2, R5.1, R16.1, R17.1, R31.1, R32.1, R33.1, RST1.2, SW1.1 (A), U1.8 (DGND), U1.13 (AD0/~CS(I2S/~LJ)), U1.21 (AGND), U2.10 (VSS), U2.19 (VSSA), U2.26 (VSS), U2.49 (VSS), U2.74 (VSS), U2.99 (VSS), U3.4 (V-), U4.4 (V-), U5.3 (GND_3), U5.6 (GND_6), U6.4 (GND), U7.2 (V-), U9.3 (GND), U10.3 (GND), U11.3 (GND), U12.3 (GND), U13.3 (GND), U14.3 (GND), U15.3 (GND), Y1.2 (G), Y1.4 (G); also elsewhere on the board
unnamed: C22.2, R24.1, R25.2, R29.1
unnamed: C37.1, R18.2, U3.1
unnamed: C38.1, R19.2, U3.7
unnamed: C42.2, R26.2, R27.1, R28.1
unnamed: C43.1, C45.2, R28.2, U7.4
unnamed: C43.2, R30.1
unnamed: C46.1, R29.2
unnamed: D1.2 (A), R41.1
unnamed: D2.2 (A), R36.2
unnamed: R17.2, U1.26 (AOUTB+)
unnamed: R16.2, U1.27 (AOUTB-)
unnamed: R33.2, U1.23 (~AMUTEC)
unnamed: R32.2, U1.28 (~BMUTEC)
unnamed: R36.1, U2.89 (PB3)
unnamed: C40.1, R22.2, U3.3 (+)
unnamed: C37.2, R20.2, U3.2 (-)
unnamed: C41.1, R23.1, U3.5 (+)
unnamed: C38.2, R21.2, U3.6 (-)
unnamed: C16.2, U5.4 (NR/FB)
unnamed: C44.1, R24.2, U7.1 (+)
unnamed: R44.1, U11.2 (IO2)
unnamed: R45.1, U12.2 (IO2)

Notes on the sheet:
Audio Goes back to shoyu as a differntial signal from the aux circuit
Audio Codec
Inverting Amplifier Aux Circuit
Audio goes into the codec input buffer as a differential pair
WAVEFORGE: SHORI REV 4
Microcontroller and UART + SWD headers + QUAD SPI Storage
Power Supply And Regulators
Output Filtering
Main Connectors: Power + AudioIn + AudioOut
UART SWITCH ON GAMEN
COG PERCISION CAPS: C36 C38 C37
AUX Connectors And Mounting Holes
Main +5V rail comes in from shoyu
Input Filtering
COG PERCISION CAPS: C45 C42 C22 C44

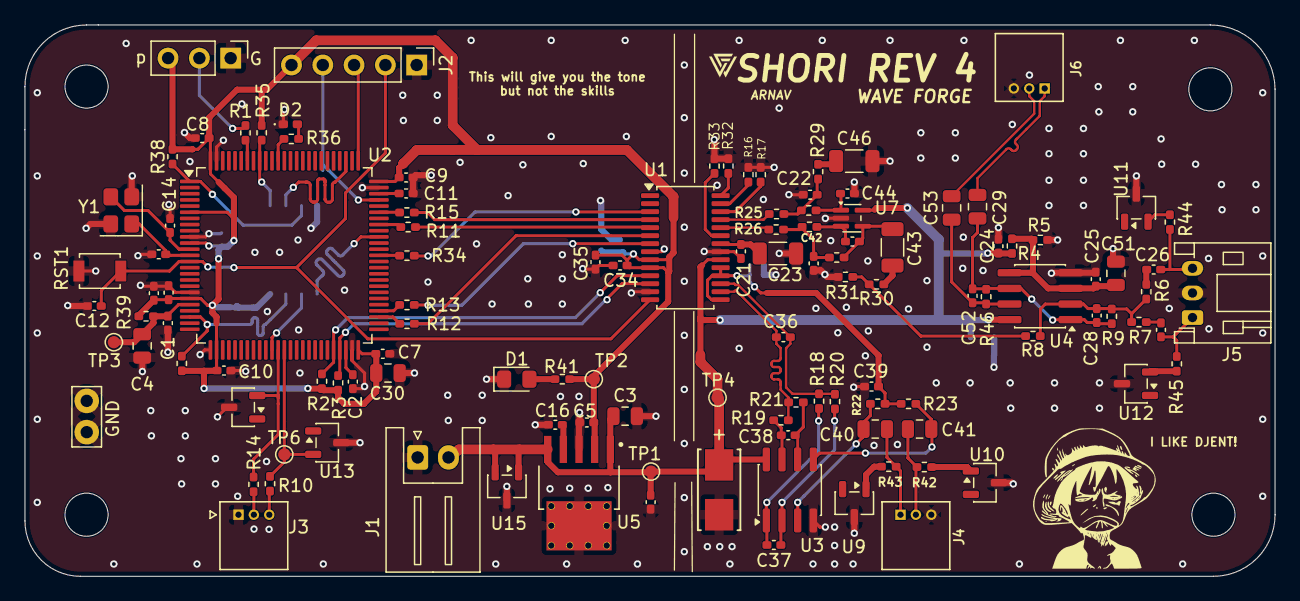
[picture p26: board shori.kicad_pcb from above]

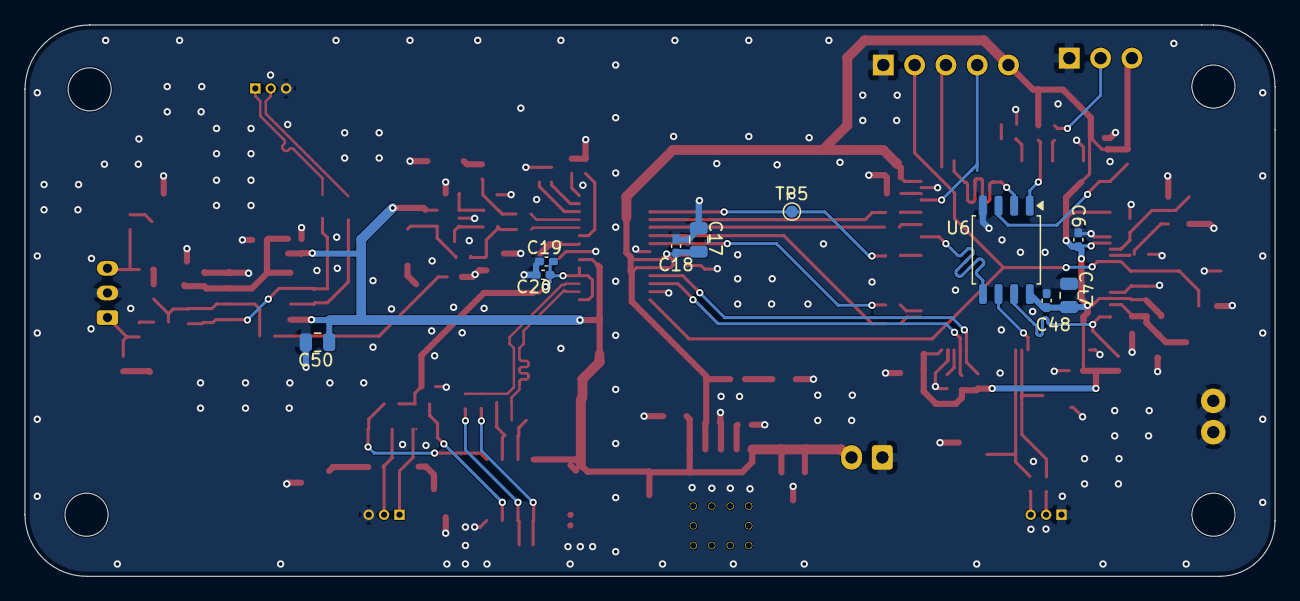
[picture p27: board shori.kicad_pcb from below]

Board: 4 copper layers, 101.5 x 44.8 mm, 133 parts (10 on the bottom side), 79 nets.

Other parts of the board:
GND: TestPoint_Bridge_Pitch2.54mm_Drill1.0mm
p: SW_SPDT; PinHeader_1x03_P2.54mm_Vertical

Their connections:
+3.3V: p.3 (C); also elsewhere on the board
/BOOT0_R_TO_SW: p.2 (B); also elsewhere on the board
GND: GND.1, p.1 (A); also elsewhere on the board
