ArnavMK/WaveForge/Hardware/shoyu/shoyu.kicad_pcb

## KiCad design Hardware/shoyu/shoyu.kicad_pcb (2026-06-24)

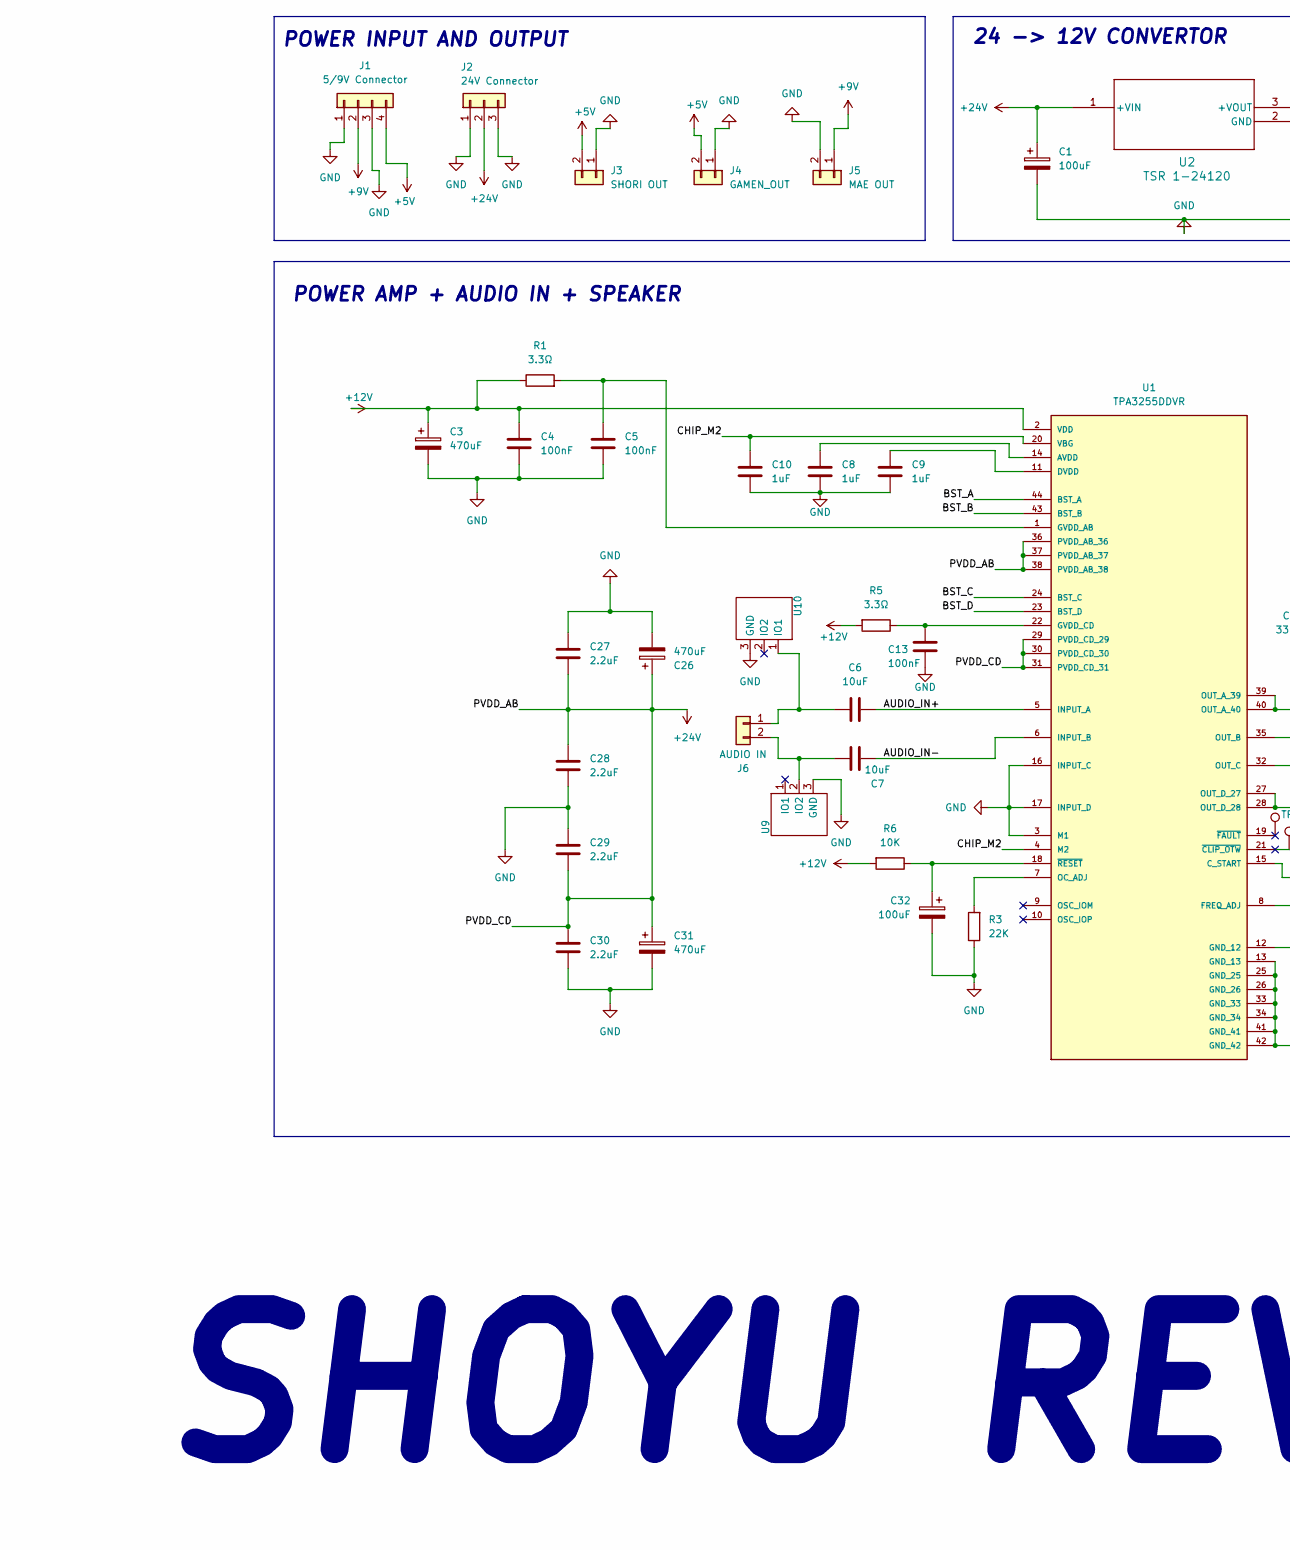
[picture p28: schematic shoyu.kicad_sch, Shoyu - Power Amplifier, part in row 1, column 1]

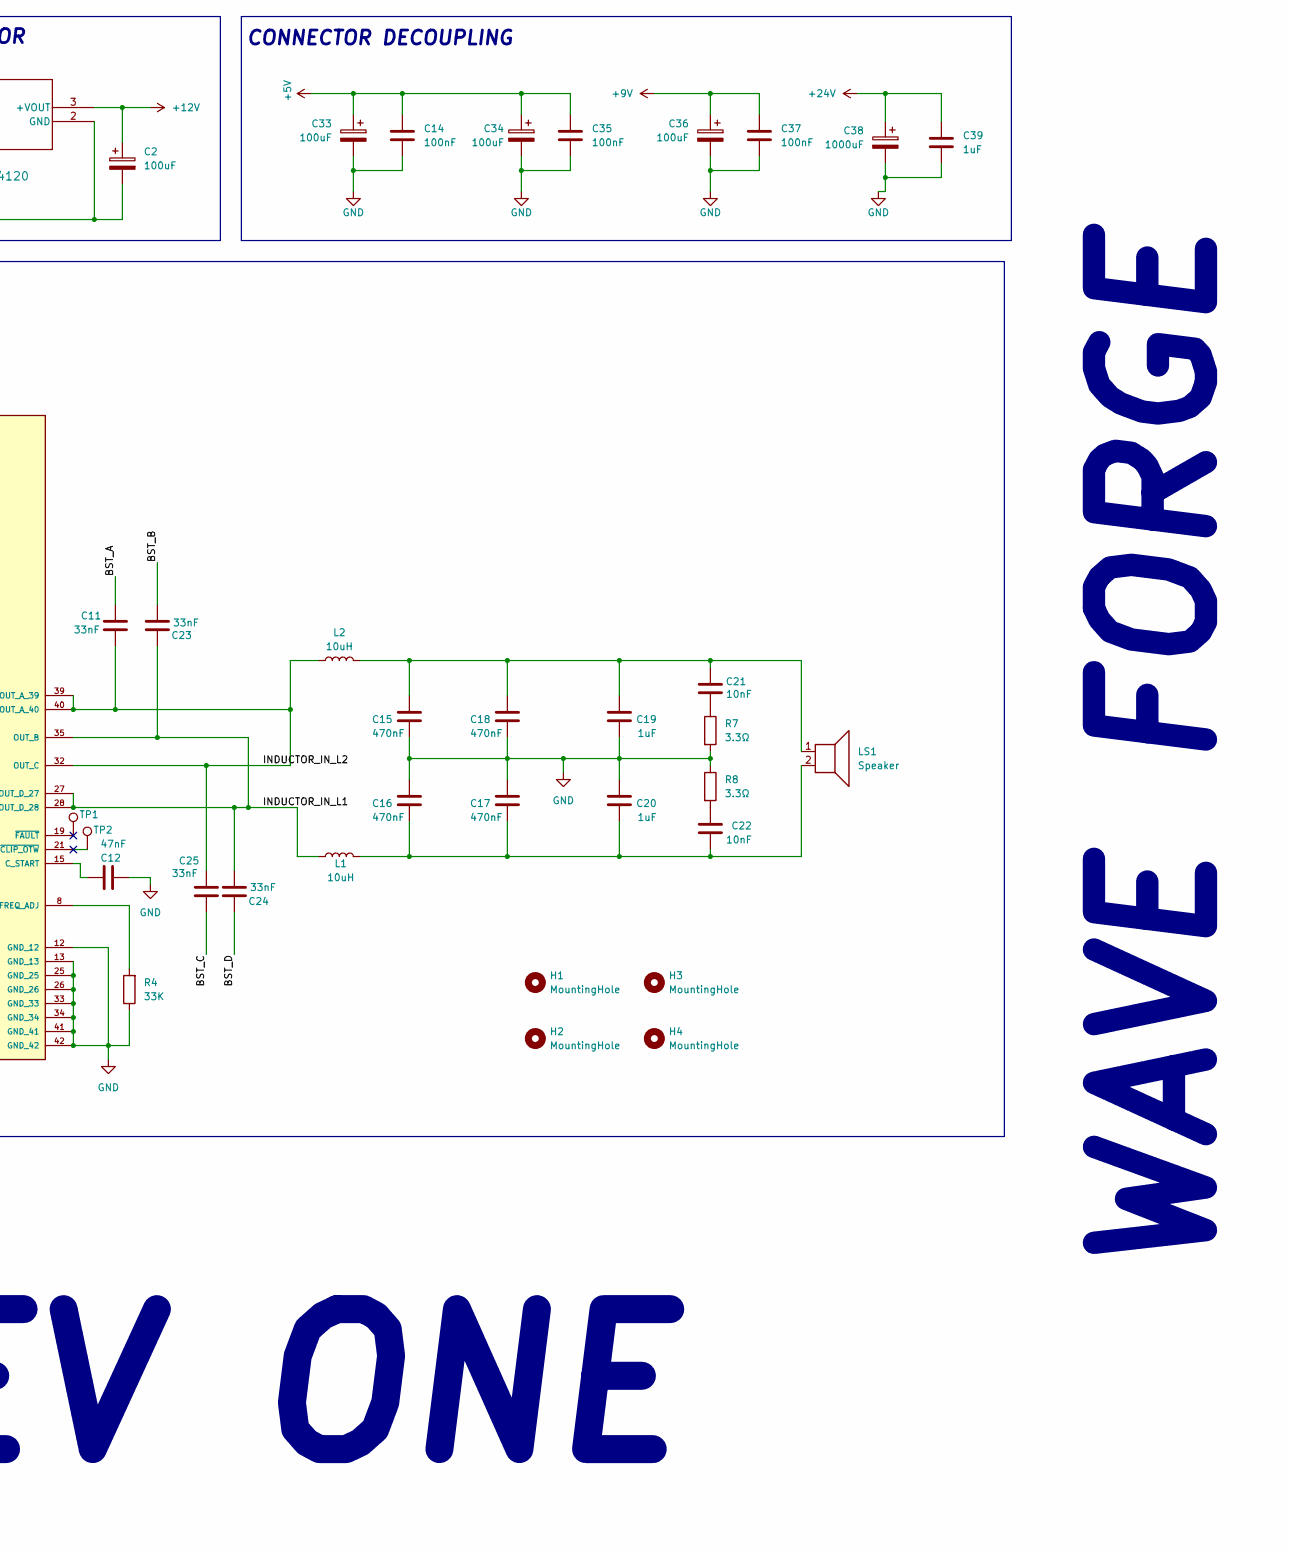
[picture p29: schematic shoyu.kicad_sch, Shoyu - Power Amplifier, part in row 1, column 2]

Parts:
C1, C2, C32, C33, C34, C36: 100uF; CP_Radial_D8.0mm_P3.50mm
C3, C26, C31: 470uF; CP_Radial_D10.0mm_P5.00mm
C4, C5, C13, C14, C35, C37: 100nF; C_0402_1005Metric_Pad0.74x0.62mm_HandSolder
C6, C7: 10uF; C_0805_2012Metric_Pad1.18x1.45mm_HandSolder
C8, C9, C10: 1uF; C_0603_1608Metric
C11, C23, C24, C25: 33nF; C_0402_1005Metric_Pad0.74x0.62mm_HandSolder
C12: 47nF; C_0402_1005Metric_Pad0.74x0.62mm_HandSolder
C15, C16, C17, C18: 470nF; C_Rect_L7.2mm_W3.5mm_P5.00mm
C19, C20, C39: 1uF; C_0603_1608Metric_Pad1.08x0.95mm_HandSolder
C21, C22: 10nF; C_0402_1005Metric_Pad0.74x0.62mm_HandSolder
C27, C28, C29, C30: 2.2uF; C_0603_1608Metric
C38: 1000uF; CP_Radial_D12.5mm_P5.00mm
H1, H2, H3, H4: MountingHole; MountingHole_2mm
J1: 5/9V Connector; JST_XH_S4B-XH-A_1x04_P2.50mm_Horizontal
J2: 24V Connector; JST_XH_S3B-XH-A_1x03_P2.50mm_Horizontal
J3: SHORI OUT; JST_XH_S2B-XH-A_1x02_P2.50mm_Horizontal
J4: GAMEN_OUT; JST_XH_S2B-XH-A_1x02_P2.50mm_Horizontal
J5: MAE OUT; JST_XH_S2B-XH-A_1x02_P2.50mm_Horizontal
J6: AUDIO IN; JST_PH_S2B-PH-K_1x02_P2.00mm_Horizontal
L1, L2: 10uH; IND_SRP1038A_BRN-M
LS1: Speaker; TerminalBlock_CUI_TB007-508-02_1x02_P5.08mm_Horizontal
R1, R5, R7, R8: 3.3Ω; R_0402_1005Metric_Pad0.72x0.64mm_HandSolder
R3: 22K; R_0402_1005Metric_Pad0.72x0.64mm_HandSolder
R4: 33K; R_0402_1005Metric_Pad0.72x0.64mm_HandSolder
R6: 10K; R_0402_1005Metric_Pad0.72x0.64mm_HandSolder
TP1, TP2: TestPoint
U1: TPA3255DDVR; HTSSOP-44_6.1x14mm_P0.635mm_TopEP4.14x7.01mm; PARTREV A
U2: TSR 1-24120; TSR1-SINGLE_TRP
U9, U10: SOT-23-3

Connections:
+5V: C14.1, C33.1, C34.1, C35.1, J1.4, J3.2, J4.2
+9V: C36.1, C37.1, J1.2, J5.1
+12V: C2.1, C3.1, C4.1, R1.1, R5.2, R6.2, U1.2 (VDD), U2.3 (+VOUT)
+24V: C1.1, C26.1, C27.2, C28.1, C29.2, C30.1, C31.1, C38.1, C39.1, J2.2, U1.29 (PVDD_CD_29), U1.30 (PVDD_CD_30), U1.31 (PVDD_CD_31), U1.36 (PVDD_AB_36), U1.37 (PVDD_AB_37), U1.38 (PVDD_AB_38), U2.1 (+VIN)
/AUDIO_IN+: C6.2, U1.5 (INPUT_A)
/AUDIO_IN-: C7.2, U1.6 (INPUT_B)
/BST_A: C11.1, U1.44 (BST_A)
/BST_B: C23.2, U1.43 (BST_B)
/BST_C: C25.2, U1.24 (BST_C)
/BST_D: C24.1, U1.23 (BST_D)
/CHIP_M2: C10.1, U1.4 (M2), U1.20 (VBG)
/INDUCTOR_IN_L1: C23.1, C24.2, L1.1, U1.27 (OUT_D_27), U1.28 (OUT_D_28), U1.35 (OUT_B)
/INDUCTOR_IN_L2: C11.2, C25.1, L2.1, U1.32 (OUT_C), U1.39 (OUT_A_39), U1.40 (OUT_A_40)
GND: C1.2, C2.2, C3.2, C4.2, C5.2, C8.2, C9.2, C10.2, C12.2, C13.1, C14.2, C15.1, C16.2, C17.2, C18.1, C19.1, C20.2, C26.2, C27.1, C28.2, C29.1, C30.2, C31.2, C32.2, C33.2, C34.2, C35.2, C36.2, C37.2, C38.2, C39.2, J1.1, J1.3, J2.1, J2.3, J3.1, J4.1, J5.2, R3.1, R4.1, R7.2, R8.1, U1.3 (M1), U1.12 (GND_12), U1.13 (GND_13), U1.16 (INPUT_C), U1.17 (INPUT_D), U1.25 (GND_25), U1.26 (GND_26), U1.33 (GND_33), U1.34 (GND_34), U1.41 (GND_41), U1.42 (GND_42), U2.2 (GND), U9.3 (GND), U10.3 (GND)
unnamed: C15.2, C18.2, C19.2, C21.2, L2.2, LS1.1
unnamed: C16.1, C17.1, C20.1, C22.1, L1.2, LS1.2
unnamed: C21.1, R7.1
unnamed: C22.2, R8.2
unnamed: C6.1, J6.1, U10.1 (IO1)
unnamed: C7.1, J6.2, U9.2 (IO2)
unnamed: TP1.1, U1.19 (~FAULT)
unnamed: TP2.1, U1.21 (~CLIP_OTW)
unnamed: C8.1, U1.14 (AVDD)
unnamed: C12.1, U1.15 (C_START)
unnamed: C9.1, U1.11 (DVDD)
unnamed: R4.2, U1.8 (FREQ_ADJ)
unnamed: C5.1, R1.2, U1.1 (GVDD_AB)
unnamed: C13.2, R5.1, U1.22 (GVDD_CD)
unnamed: R3.2, U1.7 (OC_ADJ)
unnamed: C32.1, R6.1, U1.18 (~RESET)

Notes on the sheet:
CONNECTOR DECOUPLING
24 -> 12V CONVERTOR
POWER INPUT AND OUTPUT
WAVE FORGE
SHOYU REV ONE
POWER AMP + AUDIO IN + SPEAKER
