ArnavMK/WaveForge/Hardware/shoyu/shoyu.kicad_pcb

## KiCad design Hardware/shoyu/shoyu.kicad_pcb (continued)

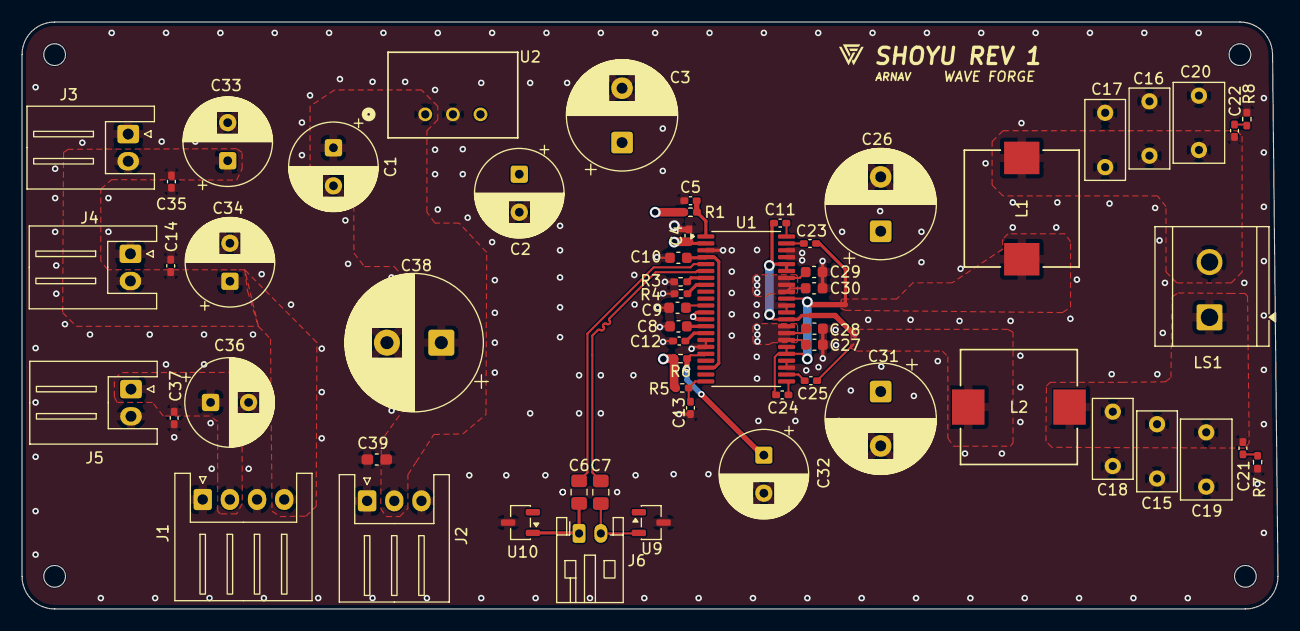
[picture p30: board shoyu.kicad_pcb from above]

Board: 4 copper layers, 115.6 x 54.0 mm, 63 parts (0 on the bottom side), 28 nets.
