ArnavMK/WaveForge/Hardware/mae/mae.kicad_pcb

## KiCad design Hardware/mae/mae.kicad_pcb (2026-06-24)

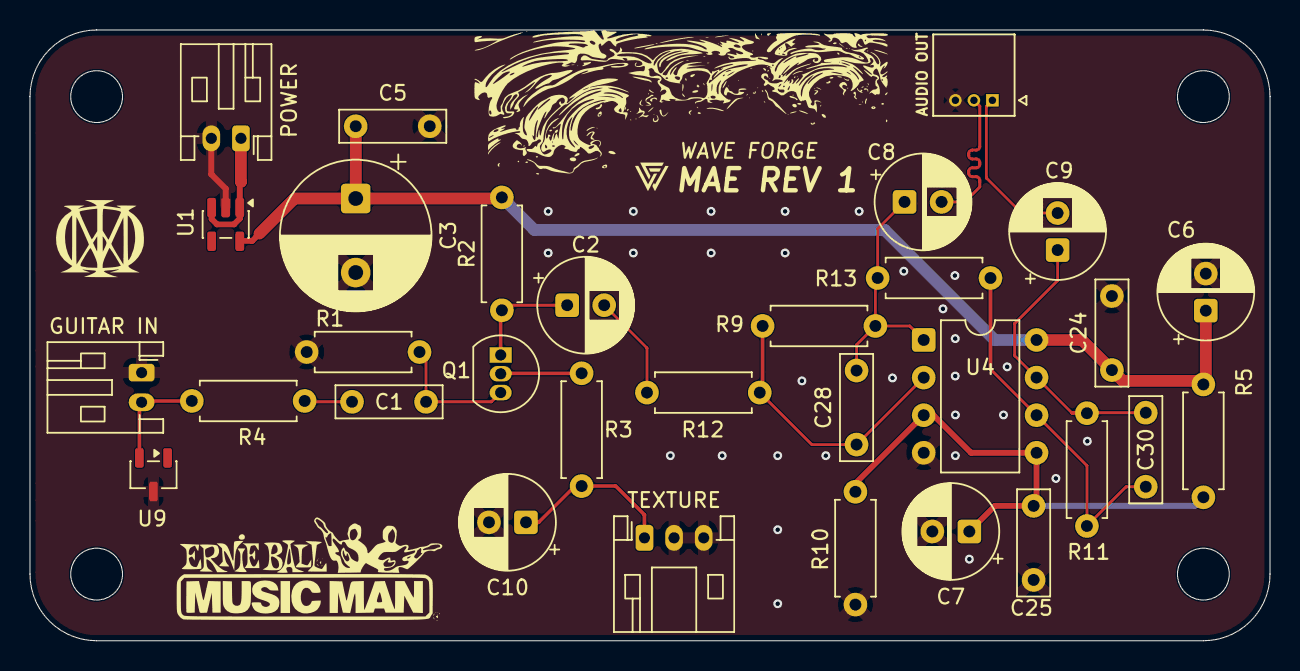
[picture p31: board mae.kicad_pcb from above]

Board: 2 copper layers, 83.8 x 41.2 mm, 35 parts (0 on the bottom side), 17 nets.

Parts:
AUDIO OUT: 530480310; MOLEX_530480310
C1, C5, C24, C25: 100nF; C_Rect_L7.0mm_W2.0mm_P5.00mm
C2, C6, C7, C8, C9: 10uF; CP_Radial_D6.3mm_P2.50mm
C3: 100uF; CP_Radial_D10.0mm_P5.00mm
C10: c; CP_Radial_D6.3mm_P2.50mm
C28, C30: 100pF; C_Rect_L7.0mm_W2.0mm_P5.00mm
GUITAR IN: Guitar_IN; JST_PH_S2B-PH-K_1x02_P2.00mm_Horizontal
H3, H4, H5, H6: MountingHole; MountingHole_3.5mm
POWER: POWER_IN; JST_PH_S2B-PH-K_1x02_P2.00mm_Horizontal
Q1: Q_NJFET_DSG; TO-92_Inline
R1: 1MΩ; R_Axial_DIN0207_L6.3mm_D2.5mm_P7.62mm_Horizontal
R2, R3: R; R_Axial_DIN0207_L6.3mm_D2.5mm_P7.62mm_Horizontal
R4: 100Ω; R_Axial_DIN0207_L6.3mm_D2.5mm_P7.62mm_Horizontal
R5, R9, R10, R11, R12, R13: 10K; R_Axial_DIN0207_L6.3mm_D2.5mm_P7.62mm_Horizontal
TEXTURE: R_Potentiometer; JST_PH_S3B-PH-K_1x03_P2.00mm_Horizontal
U1: MAX40200AUK; SOT-23-5
U4: NE5532; DIP-8_W7.62mm
U9: SOT-23-3

Connections:
+9V: C3.1, C5.1, C6.1, C24.1, R2.2, R5.1, U1.5 (OUT), U4.8 (V+)
/AUDIO_OUT+: AUDIO OUT.2, C8.2
/AUDIO_OUT-: AUDIO OUT.1, C9.2
/DRAIN: C2.1, Q1.1 (D), R2.1
/GATE: C1.2, Q1.3 (G), R1.2
/PREAMP_OUT: C2.2, R12.1
/SOURCE: Q1.2 (S), R3.2
/U4A_AUDIO: C8.1, C28.2, R9.2, R13.1, U4.1
/VBIAS: C7.1, C25.1, R5.2, R10.2, U4.3 (+), U4.5 (+)
GND: AUDIO OUT.3, C3.2, C5.2, C6.2, C7.2, C10.2, C24.2, C25.2, GUITAR IN.1, POWER.2, R1.1, R10.1, TEXTURE.2, TEXTURE.3, U1.2 (GND), U4.4 (V-), U9.3 (GND)
unnamed: C1.1, R4.2
unnamed: C10.1, R3.1, TEXTURE.1
unnamed: C9.1, C30.2, R11.2, U4.7
unnamed: GUITAR IN.2, R4.1, U9.2 (IO2)
unnamed: POWER.1, U1.1 (VDD), U1.3 (EN)
unnamed: C28.1, R9.1, R12.2, U4.2 (-)
unnamed: C30.1, R11.1, R13.2, U4.6 (-)
