ArnavMK/WaveForge/Hardware/gamen/gamen.kicad_pcb

## KiCad design Hardware/gamen/gamen.kicad_pcb (2026-05-19)

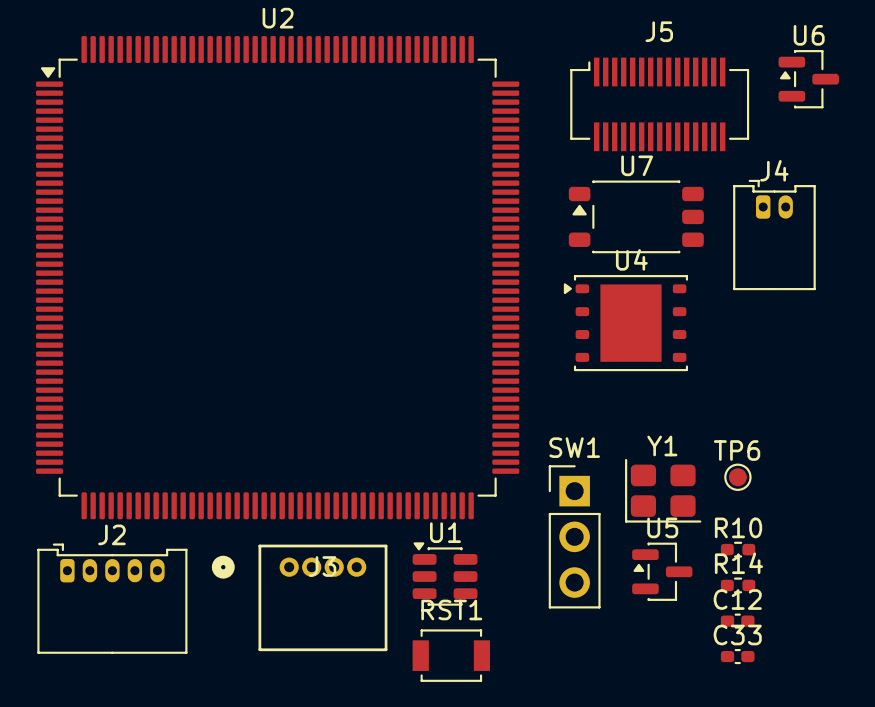
[picture p32: board gamen.kicad_pcb from above]

Board: 6 copper layers, 19 parts (1 on the bottom side), 56 nets, no tracks yet.

Parts:
C12, C33: 100nF; C_0402_1005Metric_Pad0.74x0.62mm_HandSolder
J2: Conn_01x05_Pin; Molex_PicoBlade_53048-0510_1x05_P1.25mm_Horizontal
J3: UART_Header; CONN04_530480410_MOL
J4: MIDI CONN; Molex_PicoBlade_53048-0210_1x02_P1.25mm_Horizontal
J5: SCREEN CONN; Hirose_DF12_DF12C3.0-30DS-0.5V_2x15_P0.50mm_Vertical
R10, R14: 100Ω; R_0402_1005Metric_Pad0.72x0.64mm_HandSolder
RST1: SW_Push; SW_SPST_B3U-1000P
SW1: SW_SPDT; PinHeader_1x03_P2.54mm_Vertical
TP6: TP_UARTTX; TestPoint_Pad_D1.0mm
U1: TPS562201DDCR; SOT-23-6
U2: STM32H743IITx; LQFP-176_24x24mm_P0.5mm
U3: AS4C16M16SA-6TIN; TSOP-II-54_22.2x10.16mm_P0.8mm
U4: W25Q256JWPIQ; WSON-8-1EP_6x5mm_P1.27mm_EP3.4x4.3mm
U5, U6: SOT-23
U7: TLP2361(E; SO-5-6_4.55x3.7mm_P1.27mm
Y1: 25MHz; Crystal_SMD_WE_CFPX-180-4Pin_3.2x2.5mm

Connections:
+3.3V: C33.1, J2.5, J3.1, J5.4, SW1.3 (C), U2.6 (VBAT), U2.15 (VDD), U2.23 (VDD), U2.36 (VDD), U2.49 (VDD), U2.62 (VDD), U2.72 (VDD), U2.82 (VDD), U2.91 (VDD), U2.103 (VDD), U2.114 (VDD33_USB), U2.127 (VDD), U2.136 (VDD), U2.149 (VDD), U2.159 (VDD), U2.172 (VDD), U3.1 (VDD), U3.3 (VDDQ), U3.9 (VDDQ), U3.14 (VDD), U3.27 (VDD), U3.43 (VDDQ), U3.49 (VDDQ), U4.8 (VCC), U7.6 (VDD)
+3.3VA: U2.38 (VREF+), U2.39 (VDDA)
+5V: J5.1, J5.2, U1.3 (VIN), U1.5 (EN), U6.1 (IO1), U6.2 (IO2)
/MIDI_GND: J4.1, U7.3 (K)
/NRST: C12.1, J2.2, RST1.1, U2.31 (NRST)
/OSC_IN: U2.29 (PH0), Y1.3
/OSC_OUT: U2.30 (PH1), Y1.1
/QSPI_CLK: U2.28 (PF10), U4.6 (CLK)
/QSPI_IO0: U2.27 (PF9), U4.5 (DI/IO_{0})
/QSPI_IO1: U2.26 (PF8), U4.2 (DO/IO_{1})
/QSPI_IO2: U2.25 (PF7), U4.3 (~WP/IO_{2})
/QSPI_IO3: U2.24 (PF6), U4.7 (~HOLD/~RESET/IO_{3})
/SDNIS_RAS: U2.59 (PF11), U3.18 (*RAS)
/SDRAM_A0: U2.16 (PF0), U3.23 (A0)
/SDRAM_A1: U2.17 (PF1), U3.24 (A1)
/SDRAM_A2: U2.18 (PF2), U3.25 (A2)
/SDRAM_A3: U2.19 (PF3), U3.26 (A3)
/SDRAM_A4: U2.20 (PF4), U3.29 (A4)
/SDRAM_A5: U2.21 (PF5), U3.30 (A5)
/SDRAM_A6: U2.60 (PF12), U3.31 (A6)
/SDRAM_A7: U2.63 (PF13), U3.32 (A7)
/SDRAM_A8: U2.64 (PF14), U3.33 (A8)
/SDRAM_A9: U2.65 (PF15), U3.34 (A9)
/SDRAM_A10: U2.66 (PG0), U3.22 (A10/AP)
/SDRAM_A11: U2.67 (PG1), U3.35 (A11)
/SDRAM_A12: U2.106 (PG2), U3.36 (A12)
/SDRAM_BA0: U2.108 (PG4), U3.20 (BA0)
/SDRAM_BA1: U2.109 (PG5), U3.21 (BA1)
/SDRAM_CAS: U2.160 (PG15), U3.17 (*CAS)
/SDRAM_CKE: U2.35 (PC3_C), U3.37 (CKE)
/SDRAM_CLK: U2.112 (PG8), U3.38 (CLK)
/SDRAM_CS: U2.34 (PC2_C), U3.19 (*CS)
/SDRAM_DQ0: U2.104 (PD14), U2.142 (PD0), U3.2 (DQ0)
/SDRAM_DQ1: U2.105 (PD15), U3.4 (DQ1)
/SDRAM_DQ3: U2.143 (PD1), U3.7 (DQ3)
/SDRAM_DQ4: U2.70 (PE9), U3.8 (DQ4)
/SDRAM_DQ5: U2.69 (PE8), U3.10 (DQ5)
/SDRAM_DQ6: U2.68 (PE7), U3.11 (DQ6)
/SDRAM_DQ7: U2.73 (PE10), U3.13 (DQ7)
/SDRAM_DQ8: U2.74 (PE11), U3.42 (DQ8)
/SDRAM_DQ9: U2.75 (PE12), U3.44 (DQ9)
/SDRAM_DQ10: U2.76 (PE13), U3.45 (DQ10)
/SDRAM_DQ11: U2.77 (PE14), U3.47 (DQ11)
/SDRAM_DQ12: U2.78 (PE15), U3.48 (DQ12)
/SDRAM_DQ13: U2.96 (PD8), U3.50 (DQ13)
/SDRAM_DQ14: U2.97 (PD9), U3.51 (DQ14)
/SDRAM_DQ15: U2.98 (PD10), U3.53 (DQ15)
/SDRAM_NBL0: U2.169 (PE0), U3.15 (LDQM)
/SDRAM_NBL1: U2.170 (PE1), U3.39 (UDQM)
/SDRAM_WE: U2.32 (PC0), U3.16 (*WE)
/SWCLK: J2.3, U2.137 (PA14)
/SWDIO: J2.4, U2.124 (PA13)
/UART_RX: J3.3, R14.1, U2.93 (PB13), U5.2 (IO2)
/UART_TX: J3.2, R10.1, U2.92 (PB12), U5.1 (IO1)
/UART_TX_RES: R10.2, TP6.1 (1_1)
GND: C12.2, C33.2, J2.1, J3.4, J5.3, J5.29, RST1.2, SW1.1 (A), U1.1 (GND), U2.14 (VSS), U2.22 (VSS), U2.37 (VSSA), U2.48 (VSS), U2.61 (VSS), U2.71 (VSS), U2.90 (VSS), U2.102 (VSS), U2.113 (VSS), U2.126 (VSS), U2.135 (VSS), U2.148 (VSS), U2.158 (VSS), U3.6 (VSSQ), U3.12 (VSSQ), U3.28 (VSS), U3.41 (VSS), U3.46 (VSSQ), U3.52 (VSSQ), U3.54 (VSS), U4.4 (GND), U4.9 (EP), U5.3 (GND), U6.3 (GND), U7.4 (GND), Y1.2
