ArnavMK/WaveForge/(commit log)

2026-02-28 Shori schems rev A done
    [shori.kicad_pcb, shori.kicad_sch]
2026-03-02 Started General Component Layout
    [shori.kicad_pcb]
2026-03-02 Finished Layout on shori of digital components
    [shori.kicad_pcb]
2026-03-04 Analog side layout complete on shori
    [shori.kicad_pcb]
2026-03-04 Added Mounting holes and fixed Board outline issue
    [shori.kicad_pcb]
2026-03-04 Proper Border outline made for shori
    [shori.kicad_sch]
2026-03-04 Routes Oscillator, Gamen and Programming header.
    [shori.kicad_pcb]
2026-03-05 Rough Analog Routing complete for shori
    [shori.kicad_pcb]
2026-03-08 saved previous commit
    [shori.kicad_pcb, shori.kicad_sch]
2026-03-09 Rev 2 mcu data lines and new shoyu molex connectors
    [shori.kicad_pcb, shori.kicad_sch]
2026-03-10 Shori Rev 2 schems complete!!!!!!
    next is to add passive cvalues in the codec output filtering and assigning footprints
    [shori.kicad_pcb, shori.kicad_sch]
2026-03-10 Added footprints for shori rev 2
    [shori.kicad_pcb, shori.kicad_sch]
2026-03-10 New I2S2 Pinout and MCLK resistor added
    [shori.kicad_pcb, shori.kicad_sch]
2026-03-10 Fixed Stupid mistakes and began power and mcu layout
    [shori.kicad_pcb, shori.kicad_sch]
2026-03-12 Layout complete!!!!!!
    Next is setting up the board border and rounded corners, change the molex power connector to JST one. and start routing!!
    [shori.kicad_pcb, shori.kicad_sch]
2026-03-14 Routing and memes done!!
    [shori.kicad_pcb, shori.kicad_sch]
2026-03-14 Added flash sotrage, boot0 switch and nrst button in schems
    [shori.kicad_pcb, shori.kicad_sch]
2026-03-14 Fixed Boot0 switch
    [shori.kicad_sch]
2026-03-14 Flash, boot0 switch, led, and nrst button routed. The board is done!
    [shori.kicad_pcb, shori.kicad_sch]
2026-03-27 Rev 3 changes: RC filters, Ideal diodes, electrical fixes, and their layout
    [shori.kicad_pcb, shori.kicad_sch]
2026-03-27 Power LED added on schems
    [shori.kicad_pcb, shori.kicad_sch]
2026-04-02 Rev 3 main changes completed!
    [shori.kicad_pcb, shori.kicad_sch]
2026-04-04 removed gamen power conn and layout clean up
    [shori.kicad_pcb, shori.kicad_sch]
2026-04-05 Started Mae Schematics!!
    [mae.kicad_pcb, mae.kicad_sch, shori.kicad_pcb]
2026-04-06 Mae rev 1 schems done! power supply and audio out
    [mae.kicad_sch, shori.kicad_pcb, shori.kicad_sch]
2026-04-07 Mae footprints assigned, all through hole
    [mae.kicad_sch]
2026-04-07 Mae layout and routing complete rev 1
    [mae.kicad_pcb, mae.kicad_sch]
2026-04-09 Mae: stiching vias added
    [mae.kicad_pcb]
2026-04-10 shori final touches!
    [shori.kicad_pcb, shori.kicad_sch]
2026-04-13 ongoing cart added
    [shori.kicad_sch, shori_rev_3_order.xlsx]
2026-04-13 Shori: cleaned up flash and added more BOM
    [digikey_cart.xlsx, shori.kicad_pcb, shori.kicad_sch, shori_rev_3_order.xlsx]
2026-04-16 Shori: Final BOM touches
    [digikey_cart.xlsx, shori.kicad_pcb, shori.kicad_sch]
2026-04-18 Mae: polarised caps, new layout and prints
    [mae.kicad_pcb, mae.kicad_sch]
2026-04-27 Gen: PSU, rev 1 schems done, mae and shori orderd
    [gen.kicad_pcb, gen.kicad_sch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]
2026-04-27 Gen: Rev 1 schem done, footprints assignment underway
    [gen.kicad_pcb, gen.kicad_sch]
2026-04-28 Gen: Layout rev 1 done and routing started
    [gen.kicad_pcb, gen.kicad_sch]
2026-04-29 Gen: Layout and routing complete rev 1
    [gen.kicad_pcb, gen.kicad_sch]
2026-05-01 digikey order sheet wave forge 1 added
    [gen.kicad_pcb, shoyu.kicad_pcb, shoyu.kicad_sch]
2026-05-05 Shoyu: schems started, power input and output conns added
    [shoyu.kicad_sch]
2026-05-05 Shoyu: Schems finished Footpritns added
    [shoyu.kicad_pcb, shoyu.kicad_sch]
2026-05-06 Shoyu: Layout complete
    [shoyu.kicad_pcb, shoyu.kicad_sch]
2026-05-06 Shoyu: Right side power zones finished.
    [shoyu.kicad_pcb]
2026-05-08 Shoyu: rev 1 routing complete
    [shoyu.kicad_pcb, shoyu.kicad_sch]
2026-05-08 Shoyu: New Film caps for output filter
    [shoyu.kicad_pcb, shoyu.kicad_sch]
2026-05-09 Gen: New Routing, More memes and better buck layouts (rev 2)
    [gen.kicad_pcb, gen.kicad_sch]
2026-05-10 Shori: rev 4 changes made in seperate folder for now
    [shori-B_Cu.gbr, shori-B_Mask.gbr, shori-B_Paste.gbr, shori-B_Silkscreen.gbr, shori-Edge_Cuts.gbr, shori-F_Cu.gbr, shori-F_Mask.gbr, shori-F_Paste.gbr]
2026-05-11 Shorr rev 4 completed and gamen started
    Gamen is going to actually make me kill my self
    [gamen.kicad_pcb, gamen.kicad_sch, shori.kicad_pcb]
2026-05-11 Gamen: Power supply done and mcu basics done in shcems with minor fix in shori
    [gamen.kicad_sch, shori.kicad_sch]
2026-05-11 GAMEN: Started SDRAM
    [gamen.kicad_pcb, gamen.kicad_sch]
2026-05-13 Gamen: Screen FPC connector added
    [gamen.kicad_sch]
2026-05-19 Gamen: Screen connected to mcu
    [gamen.kicad_pcb, gamen.kicad_sch]
2026-06-23 Remvoed 3.3V on shori UART and changed tantalum cap
    [gamen.kicad_sch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]
2026-06-23 Created Gallery Folders
    [shori.kicad_sch]
2026-06-24 New Gallery Images for Reddit
    [mae.kicad_pcb, shori.kicad_pcb, shoyu.kicad_pcb]
2026-07-21 Gen: 5V buck convertor rework schems
    Changed the 5V buck convertor to fgollow a ti chip with more of a max voltage headroom for safety.
    [gen.kicad_pcb, gen.kicad_sch]
2026-09-06 Gen: Barrel Jack Or-ing Circuit, and cart made
    [gen.kicad_pcb, gen.kicad_sch]
2026-09-11 added stiching vias on gen and changed SWD header on shori to header pins
    [gen.kicad_pcb, gen.kicad_sch, shori.kicad_pcb, shori.kicad_sch]
2026-09-25 Gen rev 2 Ordered and Assembled. Proven Working All rails Spot on
    [gen-B_Cu.gbr, gen-B_Mask.gbr, gen-B_Paste.gbr, gen-B_Silkscreen.gbr, gen-Edge_Cuts.gbr, gen-F_Cu.gbr, gen-F_Mask.gbr, gen-F_Paste.gbr]
